akashskyash007/Fourth-Order-Gm-C-Chebyshev-Filter/Report.odt

PROJECT REPORT

Course Name: Active Filters

Course Code: EC447

Compiled By

Akash A (191EC102)

Kunapareddi Bhargav Rao (191EC222)

Submitted to

Professor Laxminidhi T

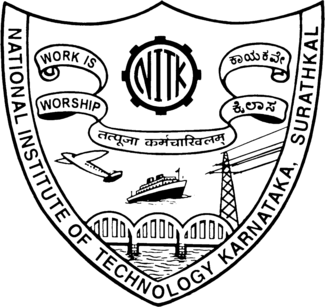
[picture p1: figure]

Problem Statement:

Design a Transconductance-C (Gm-C) low pass filter in 0.35 µm CMOS Technoogy node from TSMC using LTSpice Circuit Simulator (or any other suitable circuit simulator) for the given specifications.

Broad Expectations:

1. Realizing ideal Gm-C filter

a) Ideal filter using RLC circuits which meets the given specifications

b) Ideal Gm-C filter for the specifications using the macromodel for Gm

2. Designing the transconductor in 0.35 μm CMOS technology node from TSMC and validating its use as a Gm-C integrator. The capacitor calculated to be used in the first node of the filter may be used as the integrating capacitor for testing the Gm-C integrator.

3. Realize the transistor level Gm-C filter for the given specification.

General Specifications:

1. Fourth order Maximally flat response

2. Power supply 3.3 V

3. Use length of 0.5 μm for all transistors

4. Use even number of fingers for the transistors.

Transconductor Specifications:

1. Gm = 1 mS

2. Gate overdrive for input transistors = 200 mV

3. Input/output common-mode voltage = 1.65 V

Filter Specifications:

1. Attenuation at pass band edge = 0.5 dB

2. Band-edge= 70 Mhz

Theory: A maximally flat filter as the name suggests offers a flat magnitude response in the passband as compared to any other filter realized using the same order. The general expression for the magnitude response of an all pole low pass filter is given by:

{abs{ T_n(j %omega) }}^2 ~ = ~ { 1 } over { 1 + {abs{K_n (j %omega)}}^2 }

where,

{ abs{K_n (j %omega)} }^2 ~ = ~ B_{ 1 } %omega ^2 ~ + ~ B_{ 2 } %omega ^4 ~ + ~ ... ~ + ~ B_n %omega ^ { 2n }

for a prototype filter. n here represents the order of the filter. Mathematically, flatness of a function at a point is defined as the first and higher order derivatives of the function being equal to zero at that point. The greater the number of derivatives equal to zero, the more is the flatness of the function. We wish to make the polynomial Kn²(ɷ) maximally flat at ɷ=0 which would give maximal flatness for |Tn(jɷ )|² also at ɷ=0. Since all the derivatives if equated to zero gives a zero polynomial, we make the first (n-1) derivatives of Kn²(ɷ) with respect to ɷ² equal to zero. This gives us the result:

{ abs{K_n(j %omega)} }^2 ~ = ~ B_n %omega ^{ 2n }

The magnitude response curve of a general low pass filter is shown below:

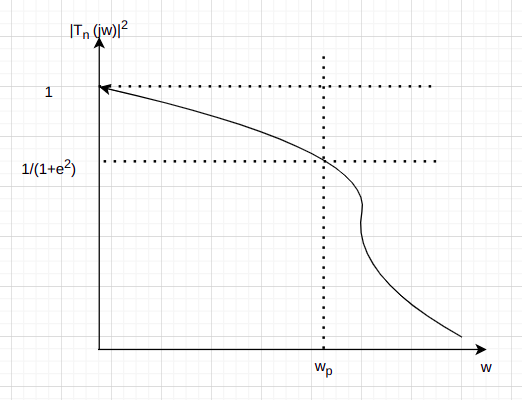
[picture p2: figure]

Thus, it can be observed that at the passband edge (ɷp = 1 rad/sec),

{ abs {T_n (j %omega)} }^2 ~ = ~ { 1 } over { 1 + %epsilon ^2 }

from which it can be shown that Kn²(ɷ) = ϵ². This in turn implies that Bn = ϵ²..

drarrow { abs {K_n (j %omega)} } ^2 ~ = ~ %epsilon ^2 %omega ^ { 2n }

drarrow { abs {T_n (j %omega)} }^2 ~ = ~ { 1 } over { 1 ~ + ~ %epsilon ^2 %omega ^ {2n} }

The special case of ϵ = 1 is known as a Butterworth filter. Attenuation can be written as the inverse of gain and in dB scale we can write the attenuation as shown below:

%alpha _{ dB } ~ = ~ 10 log(1 ~ + ~ %epsilon ^ 2 %omega ^ {2n})

From the above formulas, it is implicitt that a Butterworth filter offers a gain of -3 dB at its passband edge. A maximally flat filter can be viewed as a Butterworth filter at some other passband frequency. The expression for this passband edge can be found by equating the magnitude responses of a maximally flat and Butterworth filter and is given below:

%omega _{ p, B } ~ = %omega _ { p, MF } %epsilon ^ { -1 over n }

Thus, once we find the values of ϵ and n, we transform the maximally flat filter to a Butterworth filter and then design the Butterworth filter. This is done since the design procedure for a Butterworth filter is standardized and tables are available with numerical values that can be used to quickly design the filter.

Once we have the magnitude response, we must find the pole locations of the filter. This can be done using the relation:

{ abs {T_n (j %omega) } }^2 ~ = ~ T_n( j %omega )T_n( -j %omega ) ~ = ~ T_n( s )T_n( -s ) at s ~= ~j %omega

drarrow T_n( s )T_n( -s ) ~ = ~ { abs{T_n(j %omega)} }^2 at %omega ~= ~s over j

Thus, for a fourth order Butterworth filter that we are required to design,

T_4( s )T_4( -s ) ~ = ~ 1 over { 1 + s^8 }

The pole locations of the above transfer function are given by:

s ~ = ~ e^{ j(2k+1)%pi over 8 } ~~~~~~~~~~ for k = 0, 1, 2, ..., 7

The poles of the fourth order Butterworth filter thus lie on a unit circle and have been plotted as shown below:

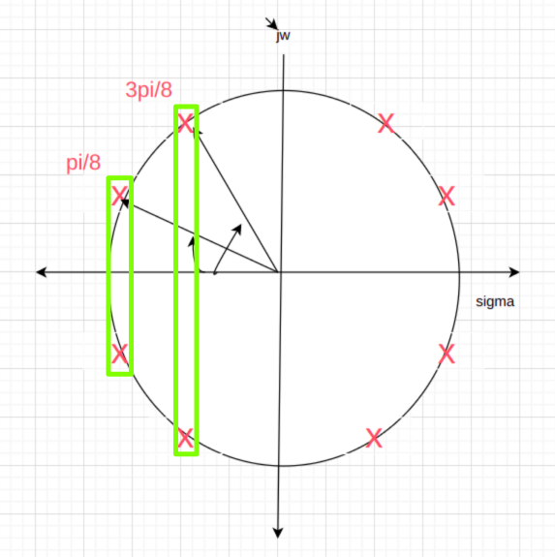
[picture p3: figure]

To ensire stability, we take the oles on the left half of the s plane to be the poles of T4(s). As shown in the above figure, the fourth order Butterworth filter can be realized using two second order sections each with passband edge of 1 rad/sec. The quality factor of a second order circuit from its pole locations on the unit circle are given by:

Q ~ = ~ 1 over { 2 cos %psi }

where ѱ is the angle made with the negative real axis by the two complex conjugate poles. From the above relation, the quality factors of the two second order filters can be shown to be Q1 = 0.541 and Q2 = 1.307. The transfer function of the fourth order filter is thus given by:

T_4( s ) ~ = ~ 1 over { (s^2 + 1.848s + 1)(s^2+0.765s+1) }

A second low pass filter can be realized using a series RLC circuit where output is taken across the capacitor. For a prototype filter, we normally choose R = 1 Ω, L = Q H and C = 1/Q F. By cascading two low pass filters with a buffer realizing using opamp to avoid the loading effect, the fourth order Butterworth filter shown above can be realized. The RLC circuit for the same is as shown below:

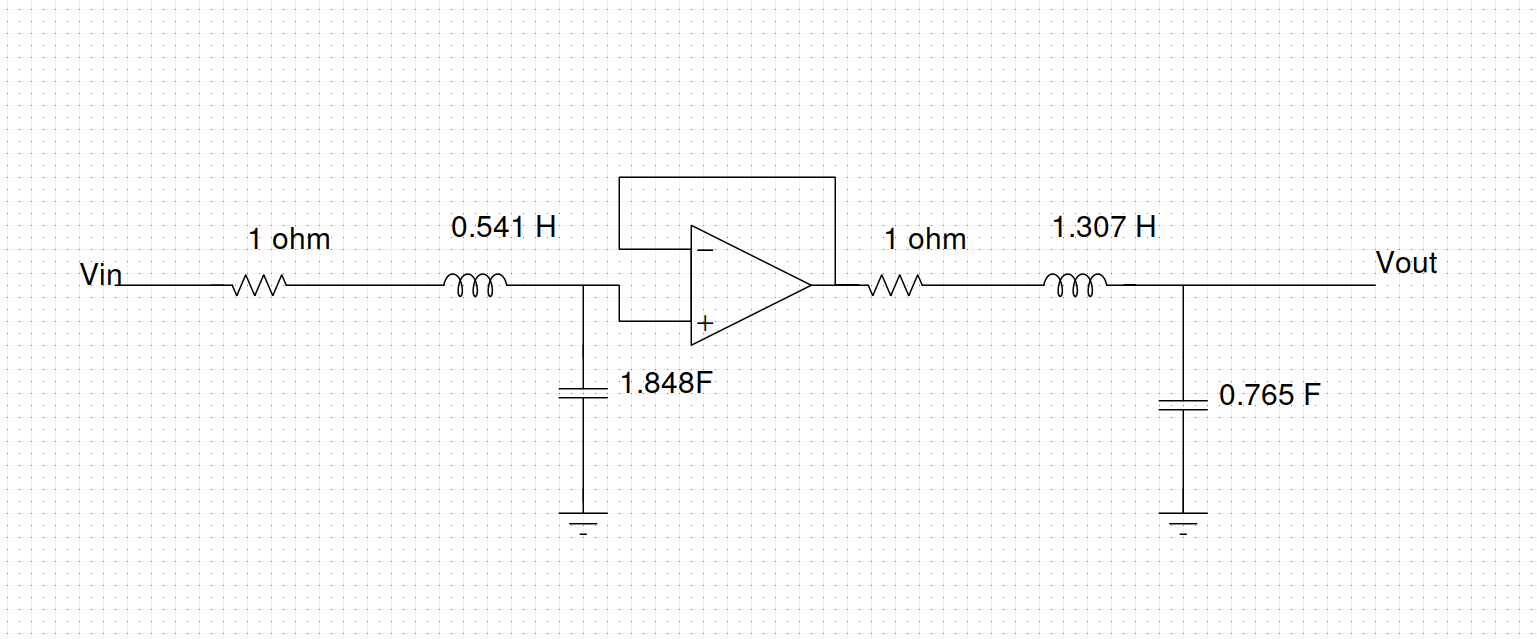
[picture p4: figure]

In order to arrive at the Gm – C equivalent, we normally start off with a band pass filter and realize the inductor and resistor using transconductors. This is done since converting the above circuit directly to its Gm – C equivalent produces a non-integrating node at the terminal between the resistor and the floating inductor and the parasitic capacitances cannot be absorbed. The bandpass equivalent has no non-integrating node and thus, the parasitic capacitances can be absorbed into the integrating caacitors. Thus, the order of the circuit remains the same and we also obtain a more exact version of the desired response. The output of the gyrator used to realize the inductor is then a low pass node. The Gm – C equivalent of the above circuit is shown below. We also note that the section with a lower quality factors have been placed and then followed by sections with high quality factors. This is done since higher quality factors have gains greater than one in their magnitude response and if placed early on in the cicuit, they will amplify the non-linear distortions to a higher extent.

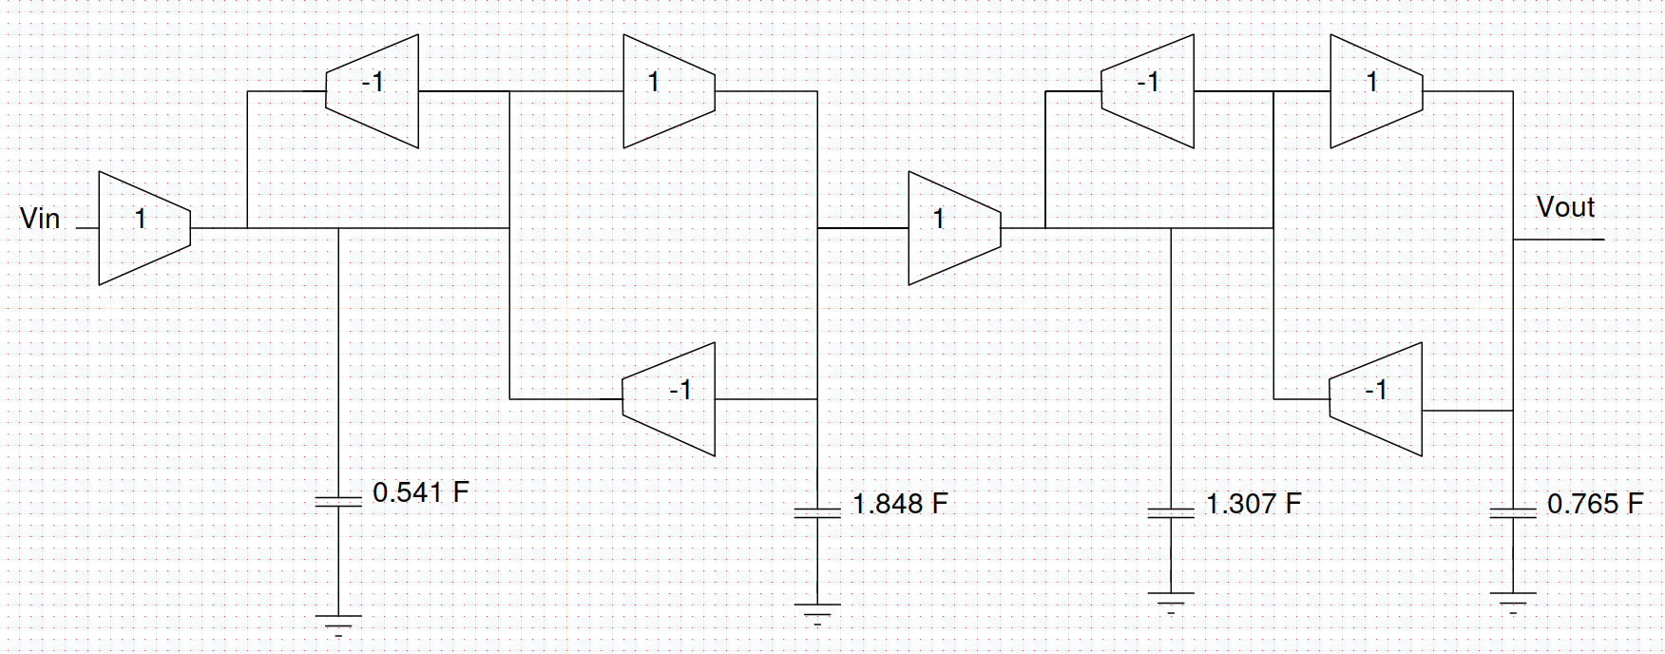
[picture p5: figure]

Design:

We are told that the attenuation at the passband edge must be -0.5 dB. Applying the formula for attenuation for a prototype (ɷp = 1 rad/sec),

0.5 ~ = ~ 10log( 1 + %epsilon ^2 ) ~ drarrow ~ %epsilon ~ = ~ 0.349

The passband edge for the maximally flat filter is given to be 70 Mhz. Since we are realizing a fourth order filter, n = 4. Thus, to convert the maximally flat filter to a Butterworth filter, we find the passband edge for the Butterworth filter using the formula told earlier.

%omega _{ p, BF } ~ = ~ ( 2 %pi * 70 ) * ( 0.349 )^( -1 over 4 ) ~ drarrow ~ %omega _{ p, BF } ~ = ~ 572.231 Mrad/sec ~= ~ 91.07 MHz

Thus, we need to design a fourth order Butterworth filter with a passband edge of 572.231 Mrad/sec. Earlier, we have designed a prototype Butterworth fourth order filter with a passband edge of 1 rad/sec. Thus, we just need to frequency scale the circuit. Further the impedance level of the prototype is 1Ω. Since the Gm value that we need to realize is 1mS, we also need to impedance scale the circuit to a resistance value of 1kΩ. The final RLC and Gm-C circuits after performing frequency and impedance scaling is as shown below:

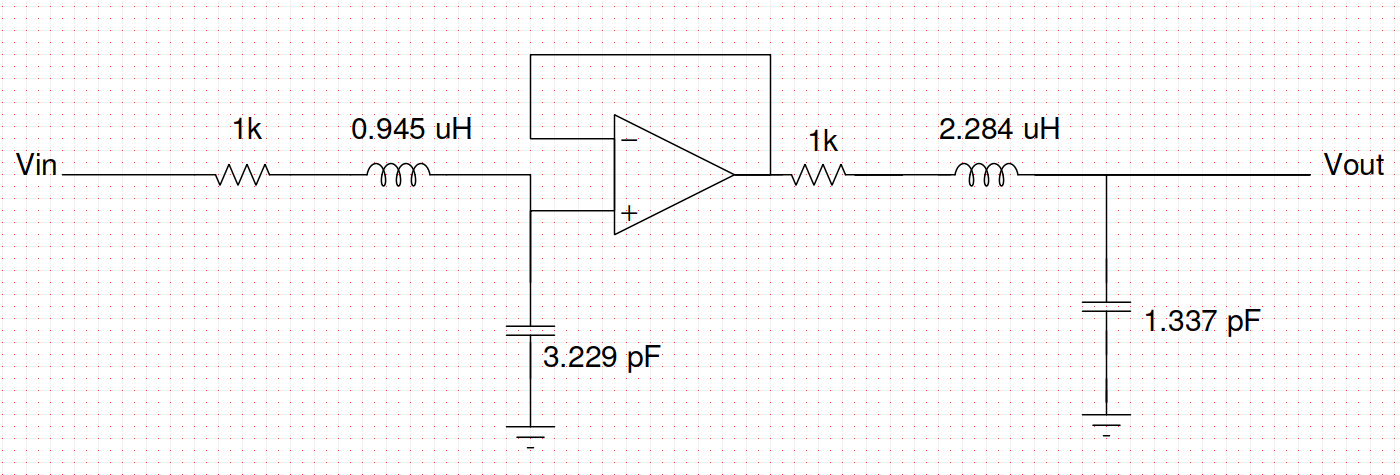
[picture p6: figure]
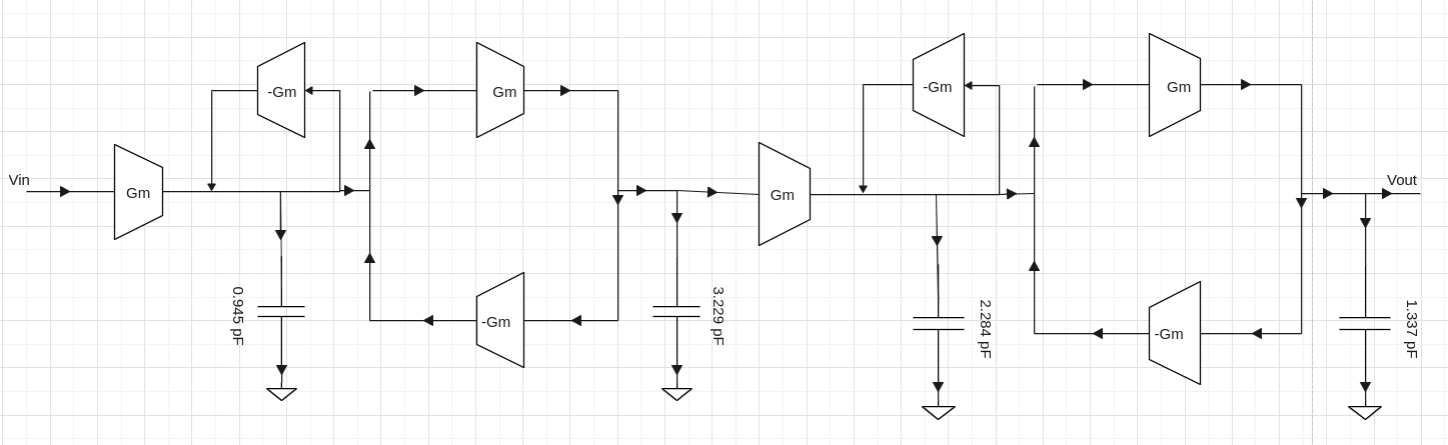
[picture p7: figure]

To design the transconductor, a common source differential pair was used with NMOS transistors as input transistors and PMOS transistors as the load transistors. Common mode feedback was implemented to ensure that the output common mode voltage is same as the input common mode voltage. This is essential for proper operation of the circuit since the output of one transconductor is given as input to the next transconductor. The basic configuration of the transconductors is as shown below:

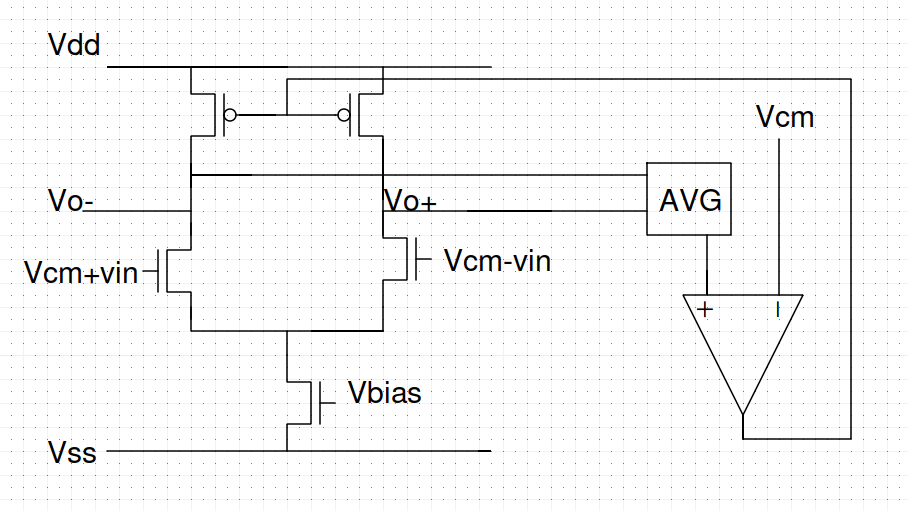
[picture p8: figure]

We need to set the width of the transistors and the drain current so that the correct transconductance (gm) is achieved. Simultaneously, specification is also given for the gate overdrive voltage Vdsat. The following expressions are used to achieve the required gm and Vdsat:

gm ~ = ~ sqrt { 2KI_D }

I_D ~ = ~ K over 2 ( Vdsat )^2

K ~= ~ %mu _n C_{ ox }( W over L )

Initially, we begin by setting arbitrary widths for the NMOS transistors and observing the values of Vdsat. If Vdsat is say less than required, we can either increase the drain current (by increasing the bias voltage to the tail NMOS) or by reducing the width of the transistors. Once, we achieve the required Vdsat, we now need to achieve the desired gm without changing the value of Vdsat. From the above expressions, to increase the gm without changing Idsat, both K and the drain current must be increased by the same factor. The reverse holds true for decreasing gm. Once we achieve the required gm and Vdsat, the transconductor is ready for use in the final circuit. We can then replace the Gm’s by the transistor level implementation and make the circuit fully differential.

SIMULATIONS AND OBSERVATIONS

1. RLC and Gm-C Macromodel Realization:

Circuit Schematic

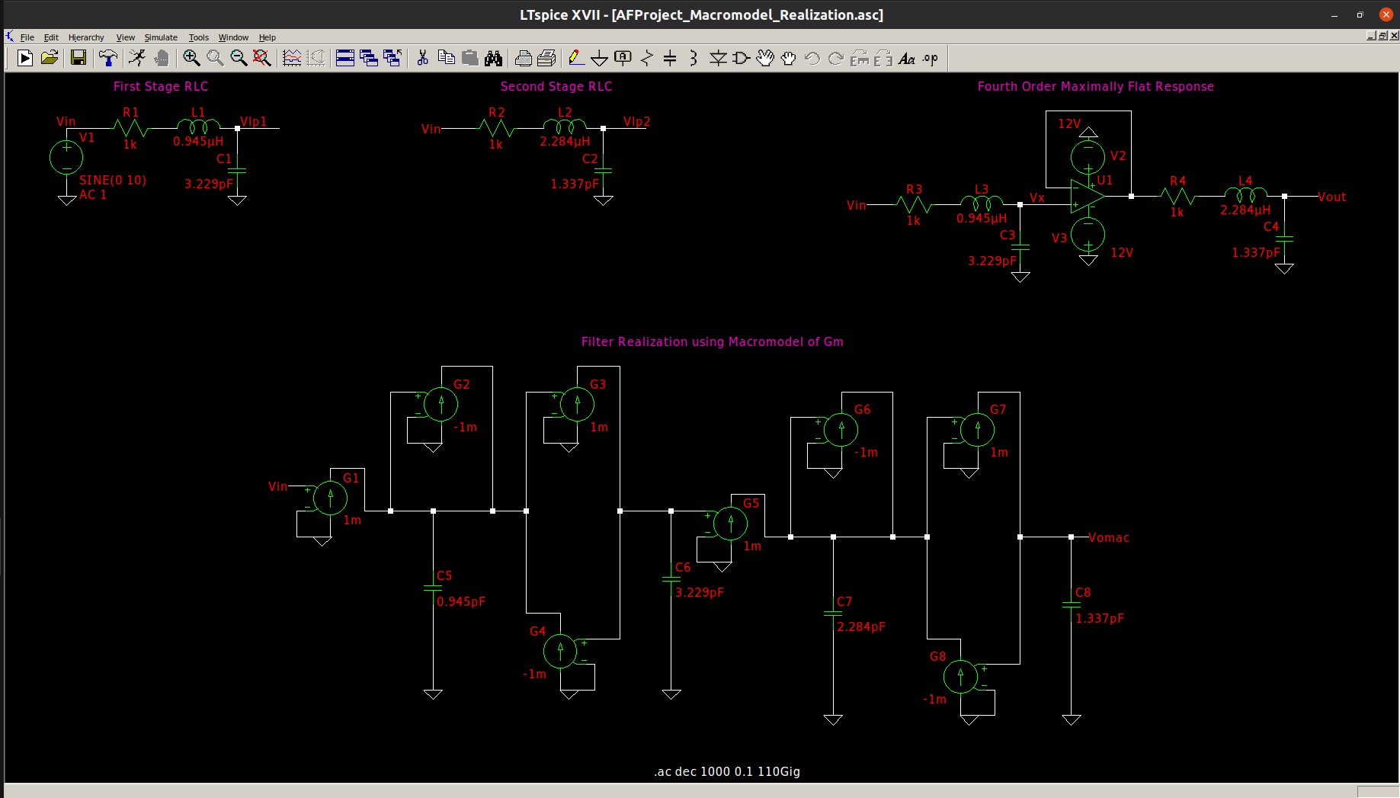
[picture p9: figure]

RLC First Stage Waveform

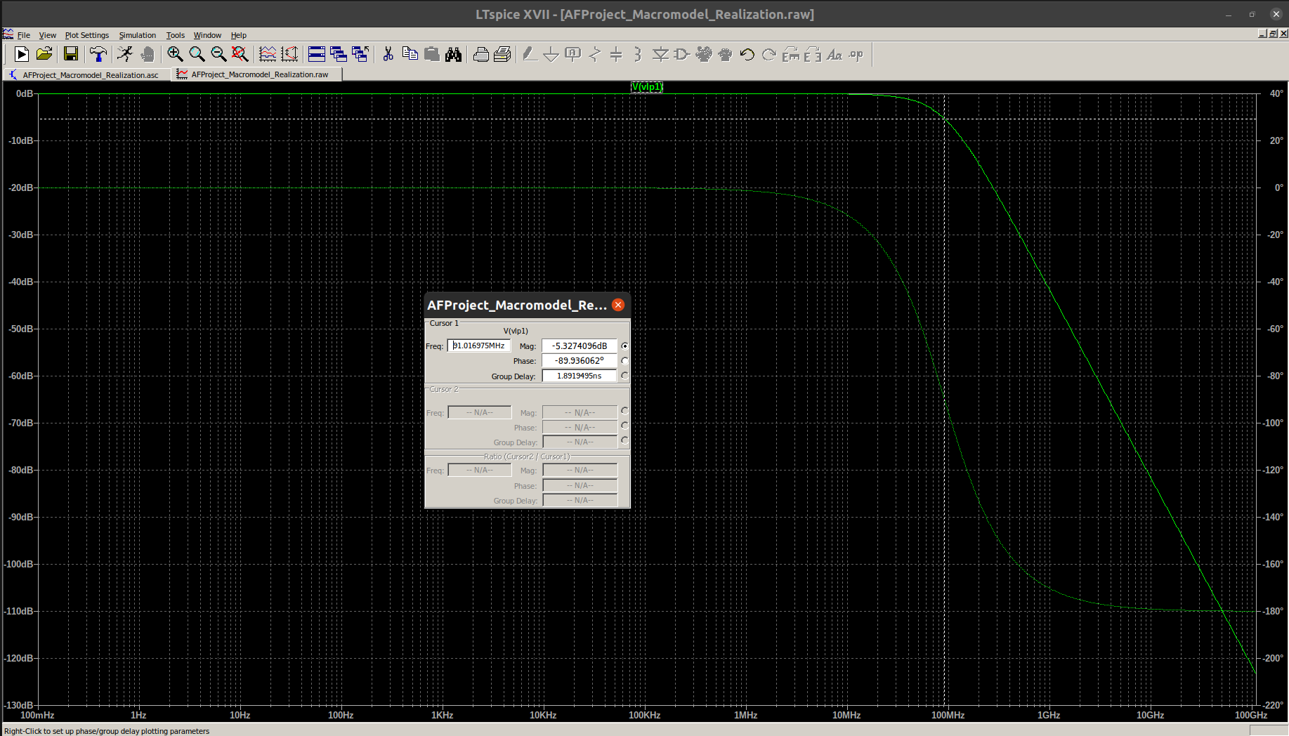
[picture p10: figure]

RLC First Stage Rolloff

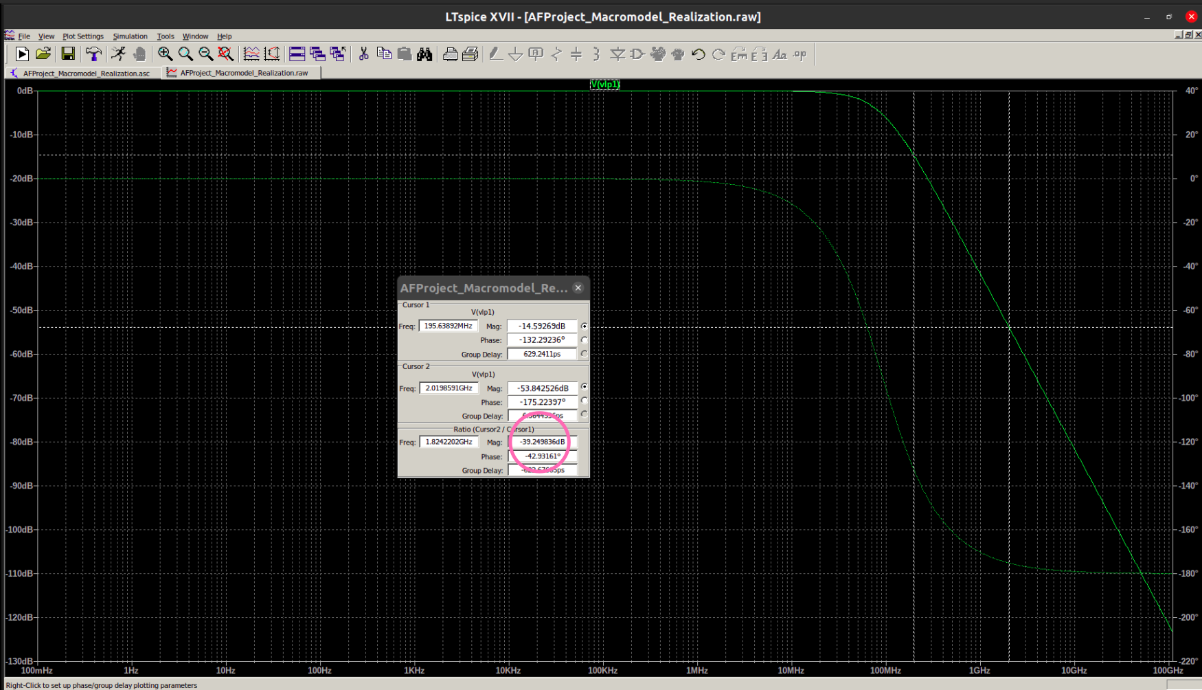
[picture p11: figure]

Second Stage RLC Waveform

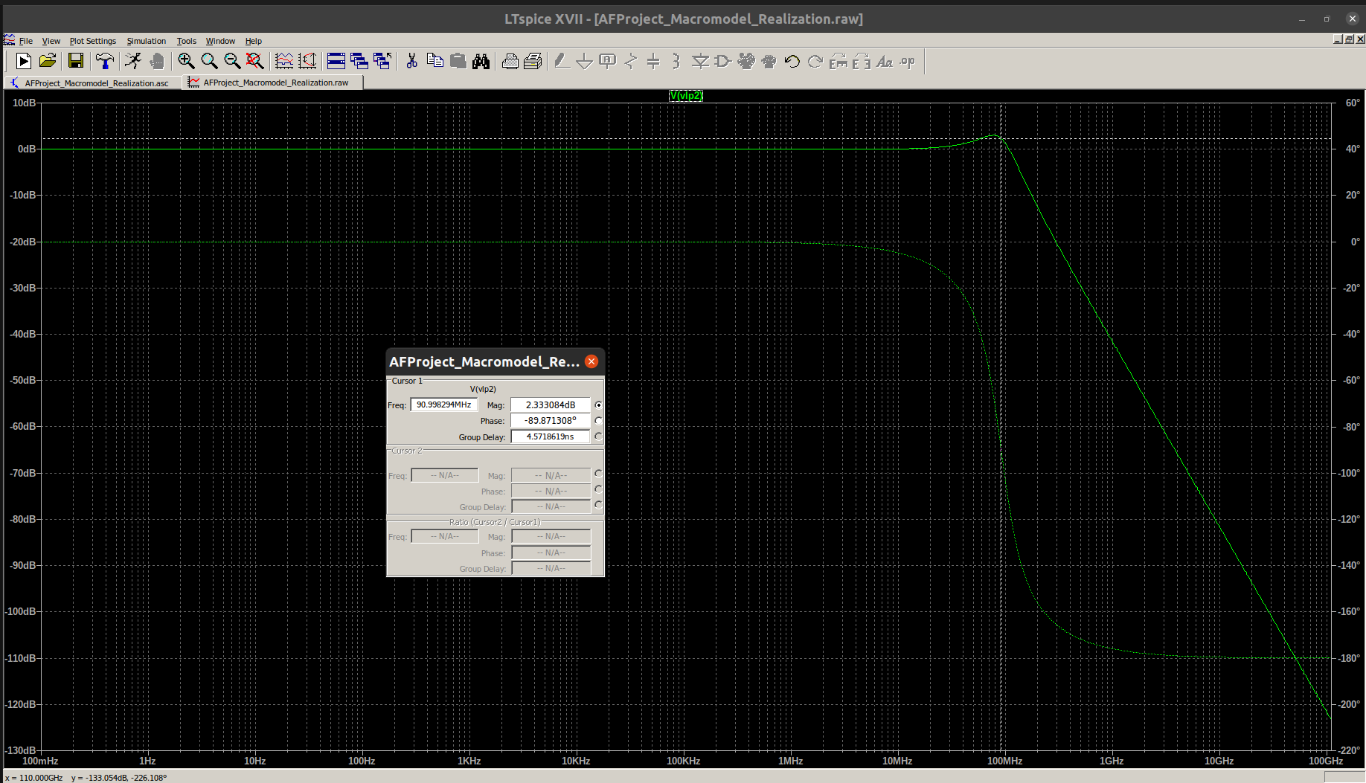
[picture p12: figure]

Second Stage RLC Rolloff

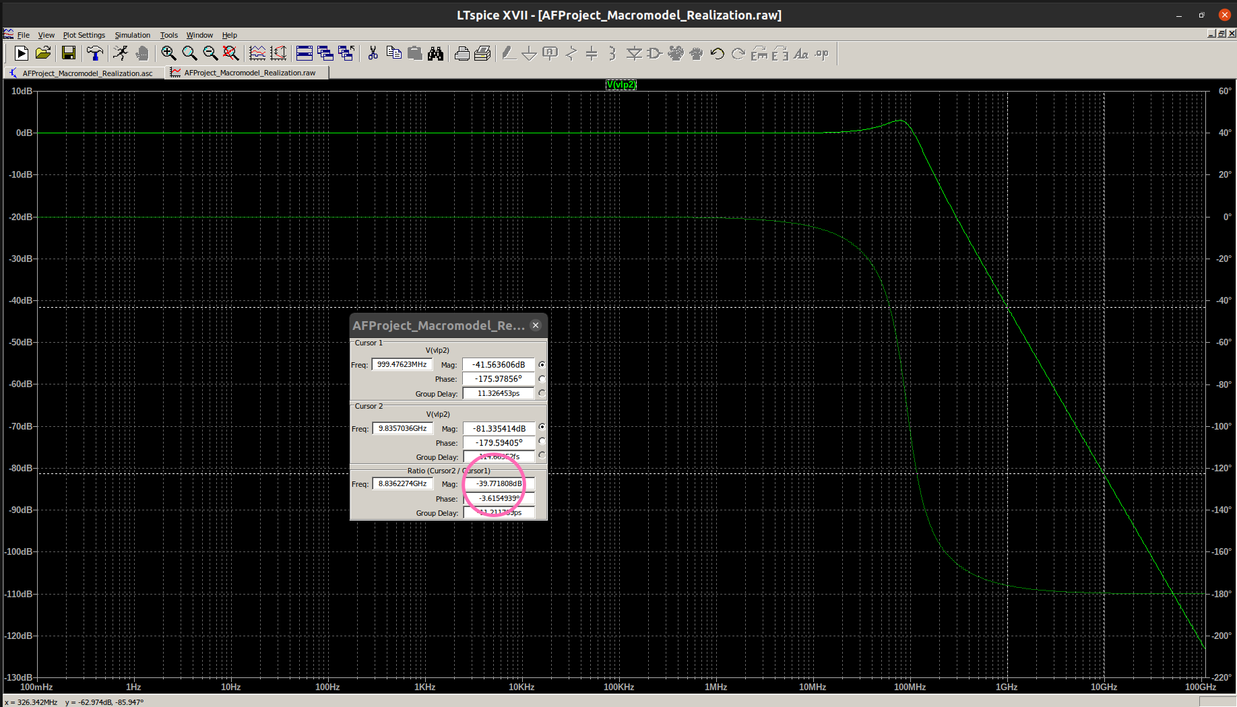
[picture p13: figure]

Complete RLC Realization Waveform

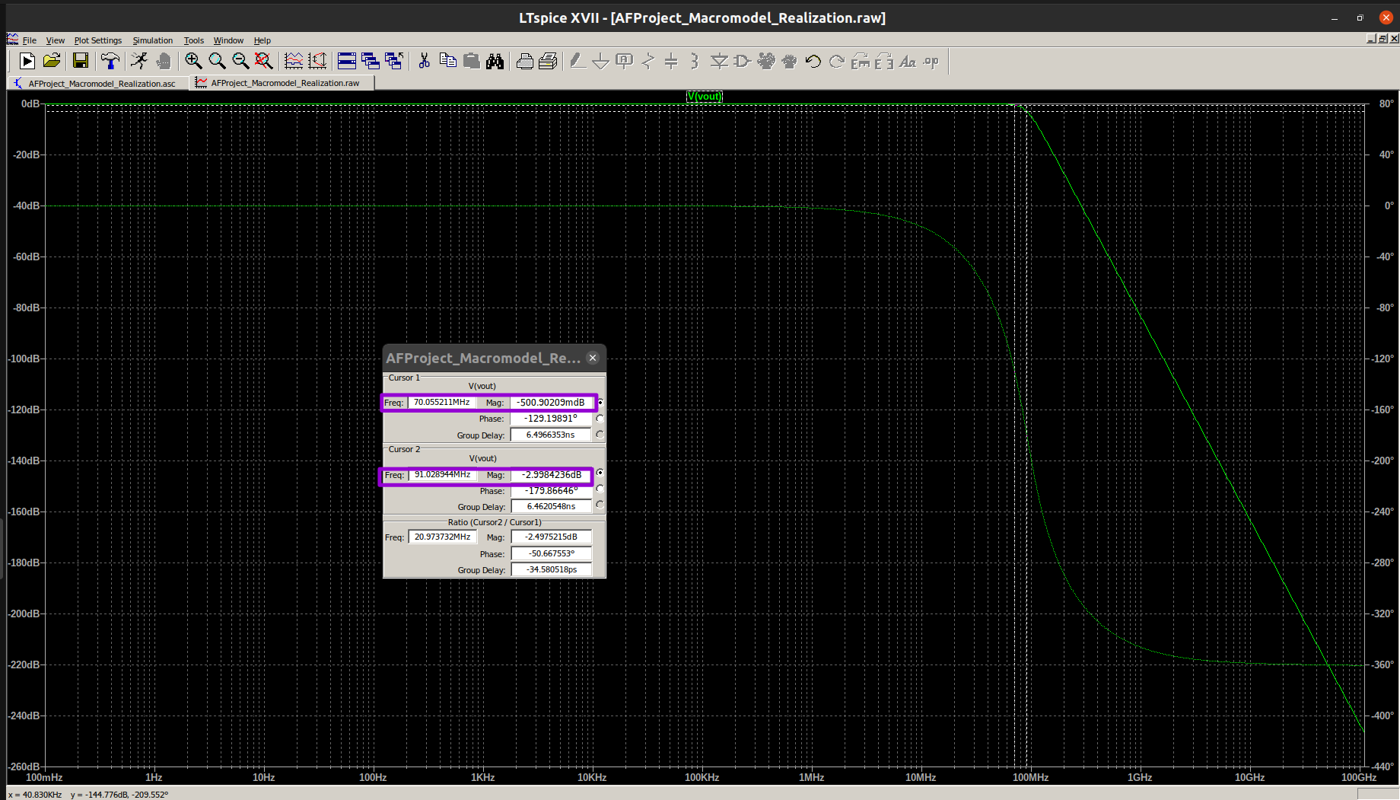
[picture p14: figure]

Complete RLC Realization Rolloff

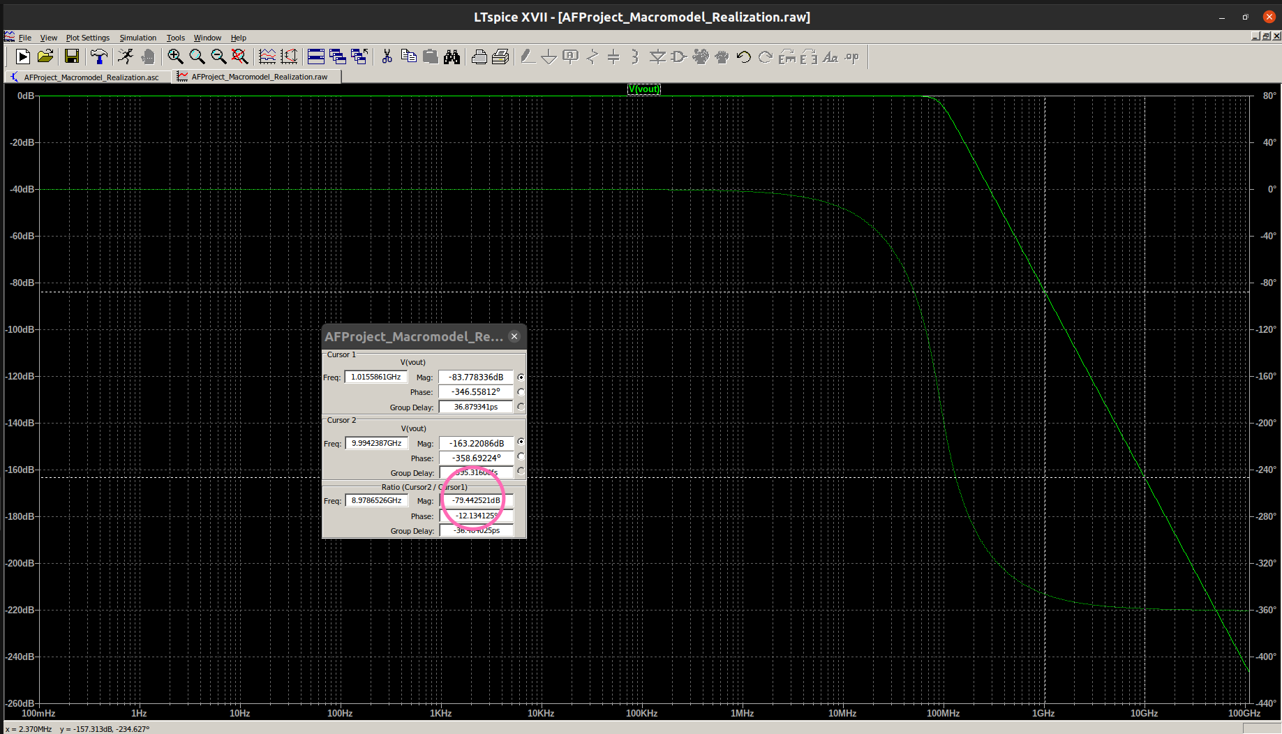
[picture p15: figure]

Gm – C Realization Waveform:

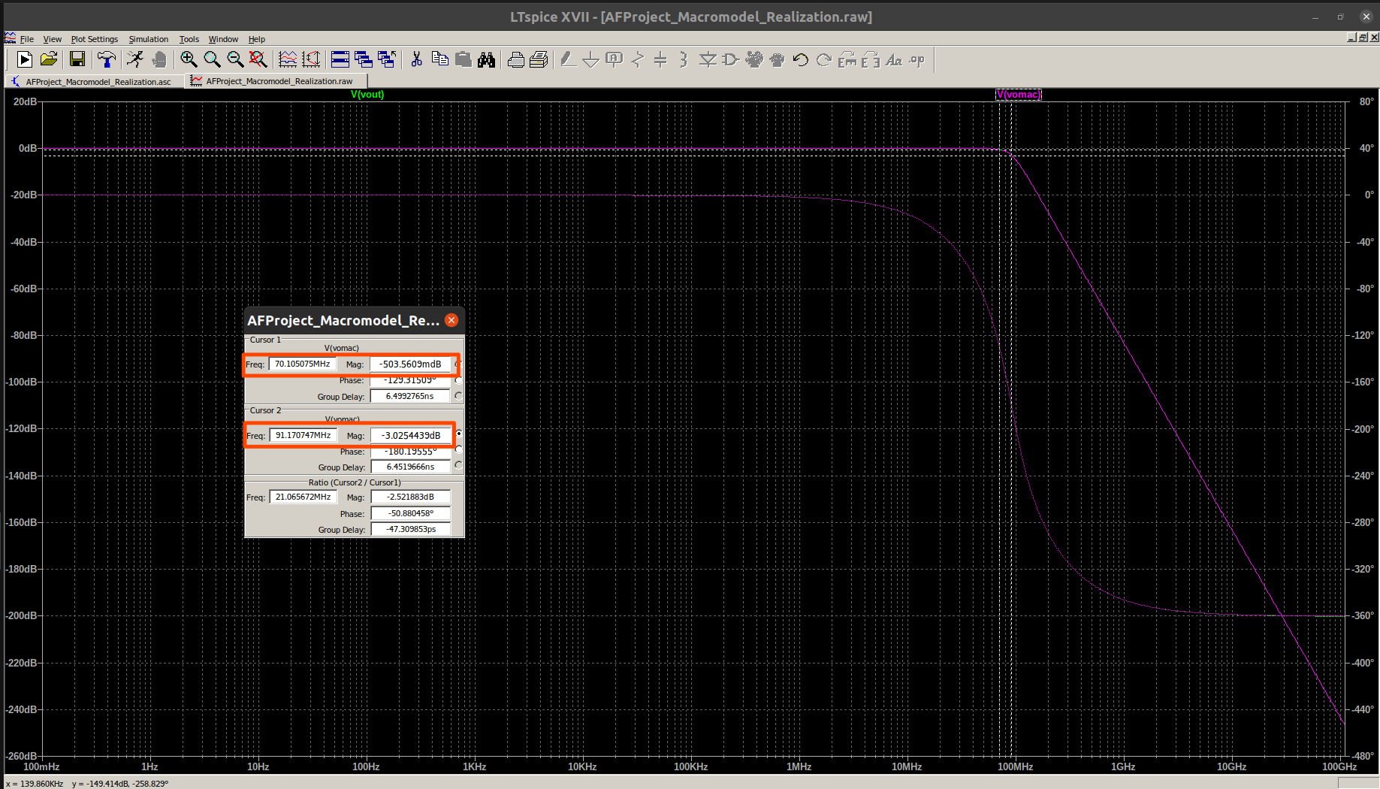
[picture p16: figure]

Observations:

- The first and second stage RLC circuits offer a DC gain of 0 dB. At the Butterworth passband edge of approximately 91 Mhz, each offers a gain equal to the quality factor in decibel. The rolloff for each of the second order filters is observed to be -40 dB/decade.
- The final fourth order RLC realization offers a gain of approximately -500 millidecibels at the passband edge of 70 Mhz and a gain of -3 dB at the Butterworth passband edge of 91 Mhz. The rolloff of the fourth order filter is observed to be -80 dB/decade. The phase plot varies from 0 degress to -360 degrees.
- The Gm – C realization exactly coincides with the RLC realization and offers the same gain and rolloff.
- Thus, the circuit realized using ideal transconductors provides the desired response which verifies the fact that our design is correct.

Now that we have realized the RLC and Gm – C macromodel circuits, the next step is to convert our singled ended circuit to a fullydifferential circuit which takes in positive and negative voltages and gives out both positive and negative voltages. This is done since differential circuits are known to offer better linearity as compared to single ended circuits. In the next step, we build a fully differential circuit using Gm macromodels. A fully differential macromodel was created in LtSpice using two voltage controlled current sources.

2. Fully Differential Macromodel Realization

Circuit Schematic

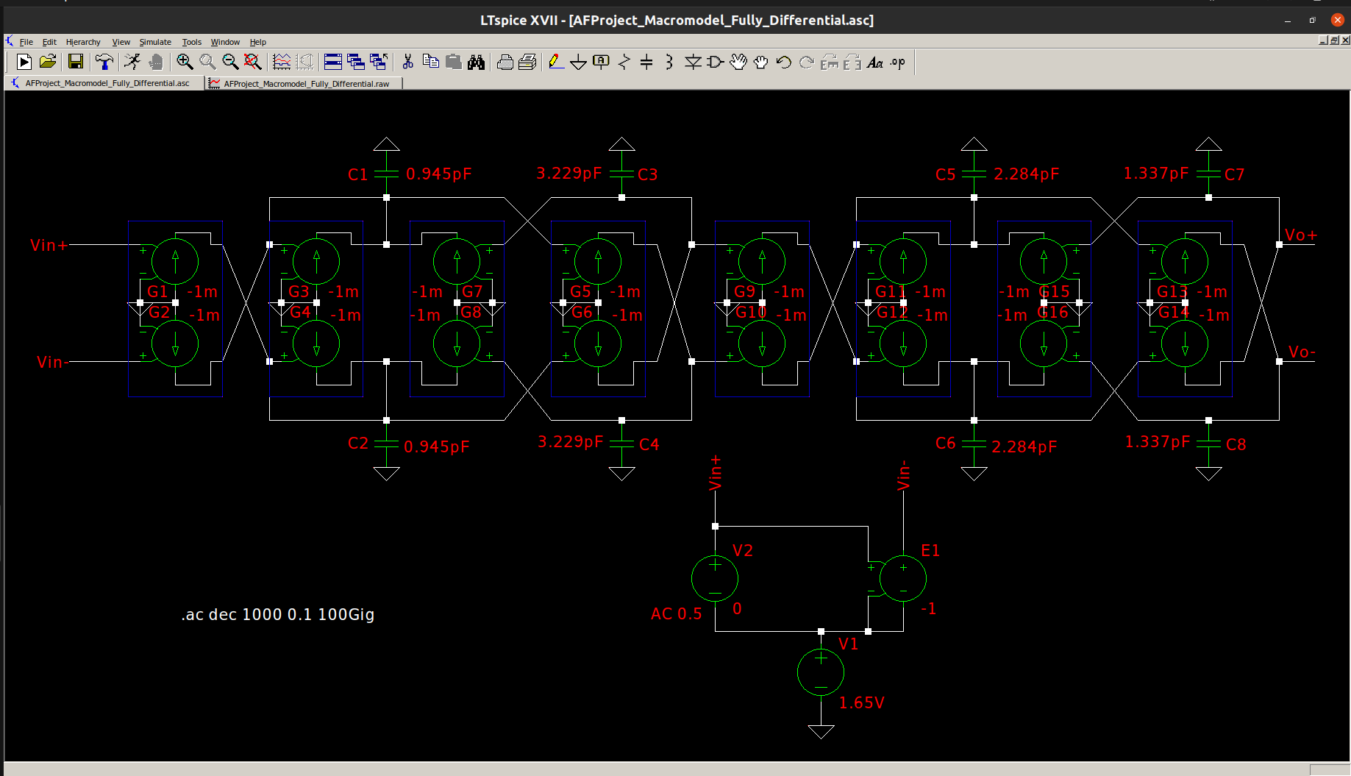
[picture p17: figure]

Waveform:

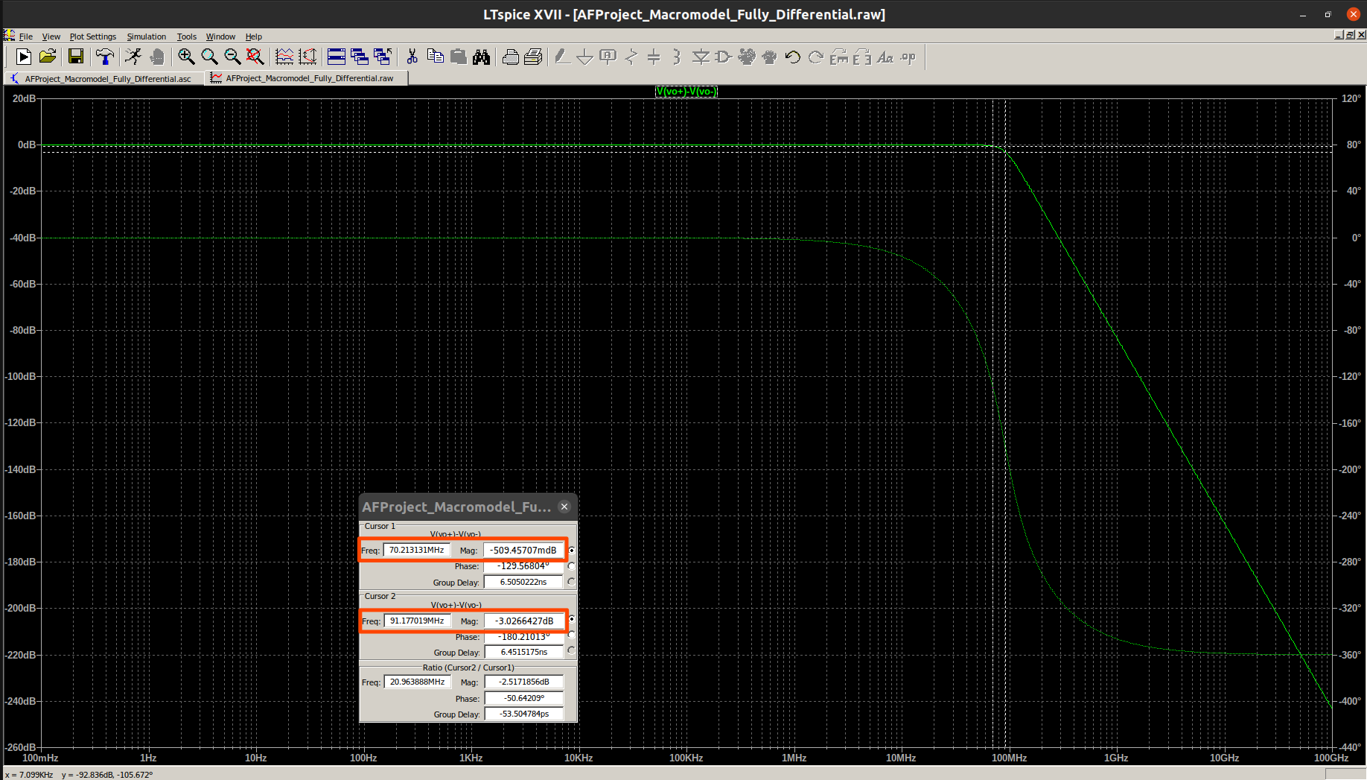
[picture p18: figure]

Rolloff:

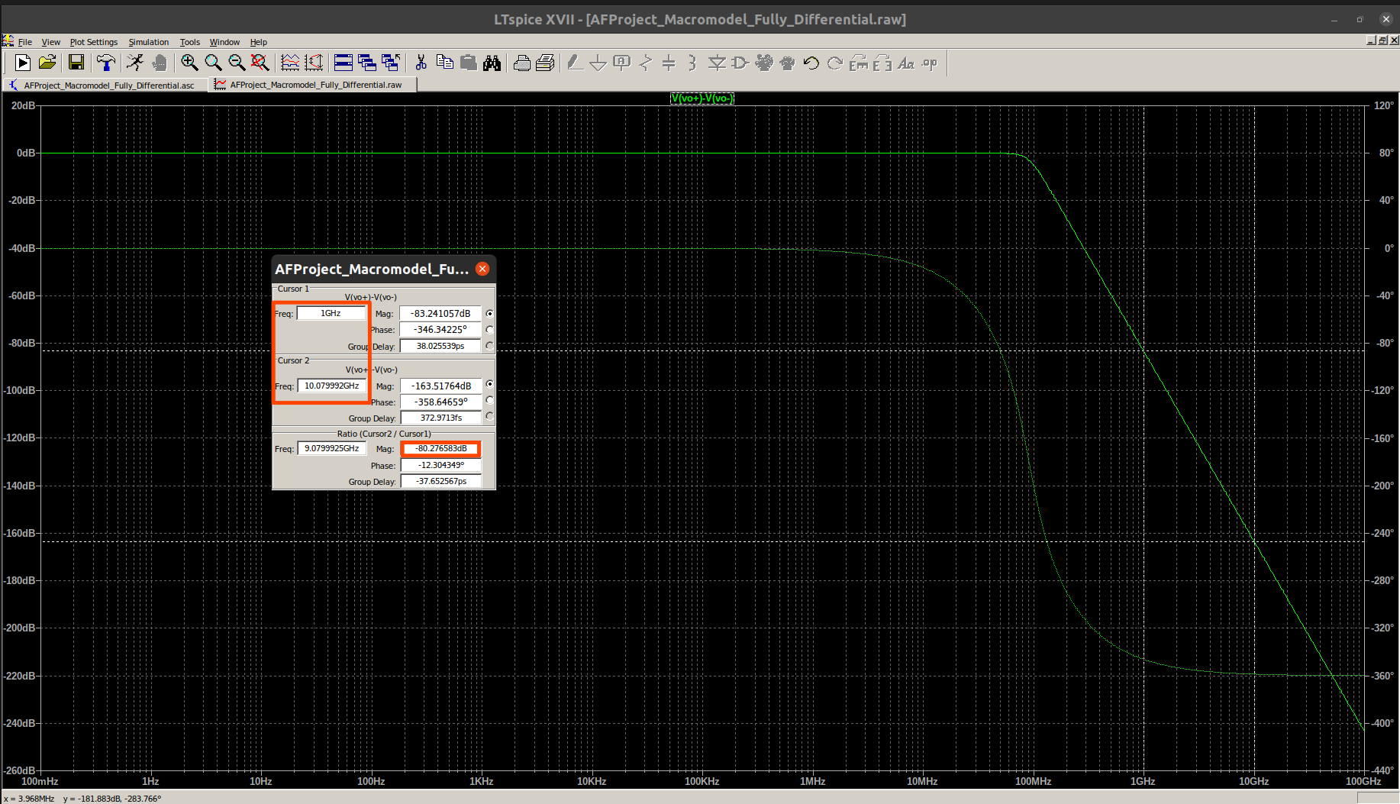
[picture p19: figure]

Thus, the fully differential circuit offers the exact same response as the single ended circuit which verifies its correctness

3. Transconductor Design:

Circuit Schematic

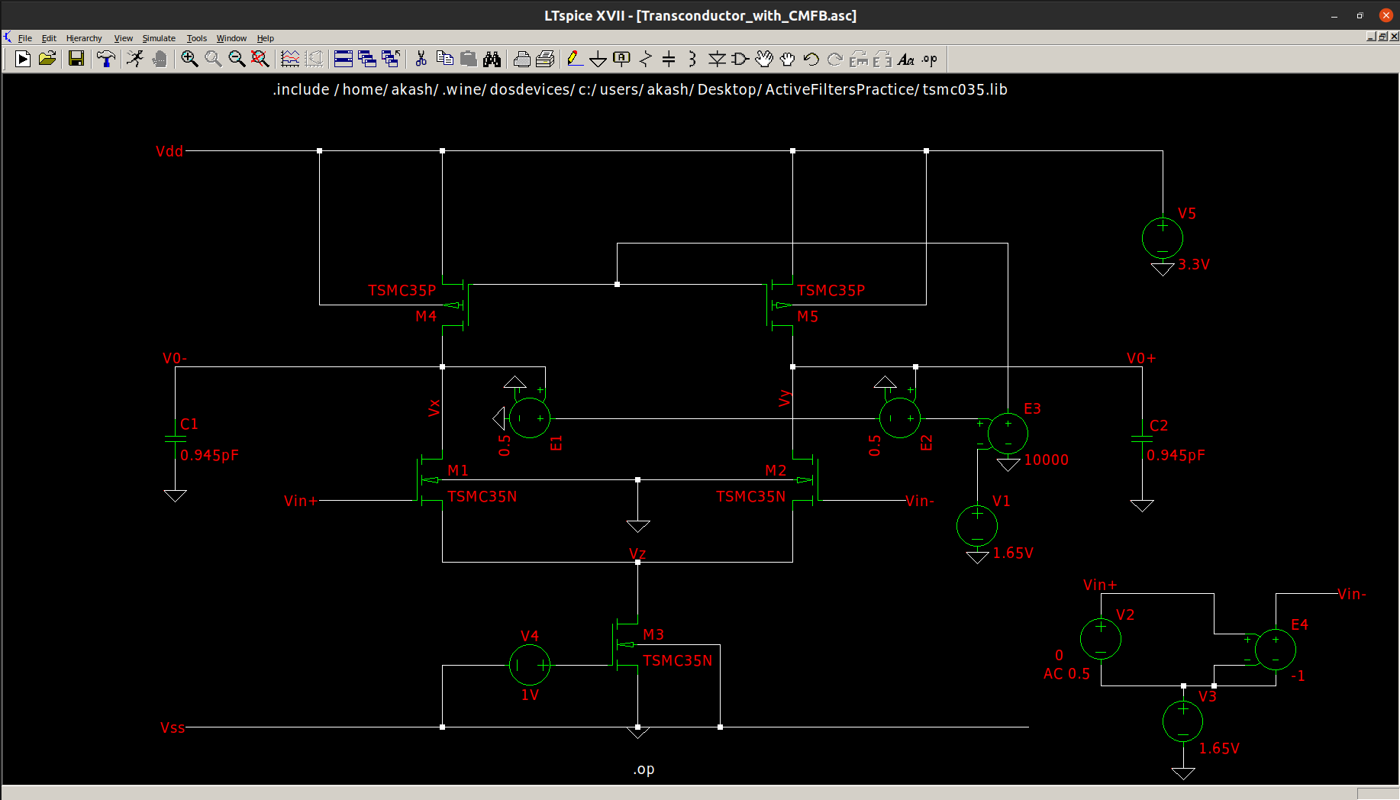
[picture p20: figure]

DC Operating Point

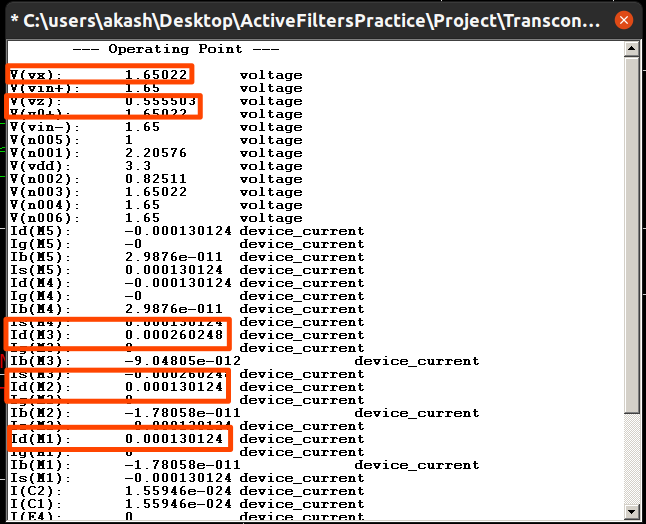
[picture p21: figure]

Spice Log:

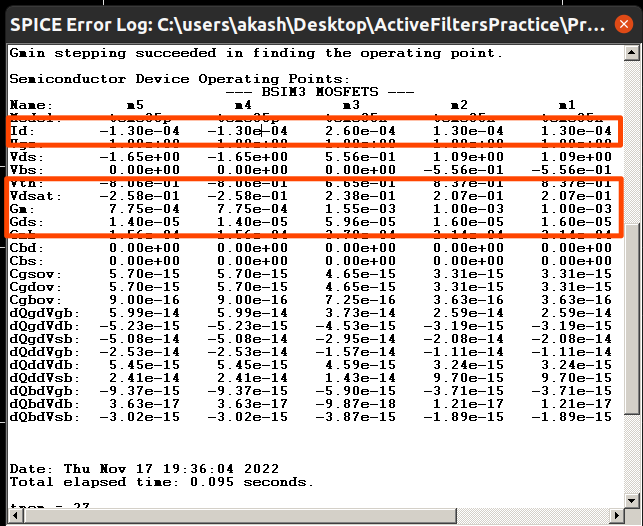
[picture p22: figure]

Output Voltage Waveform of Gm – C integrator

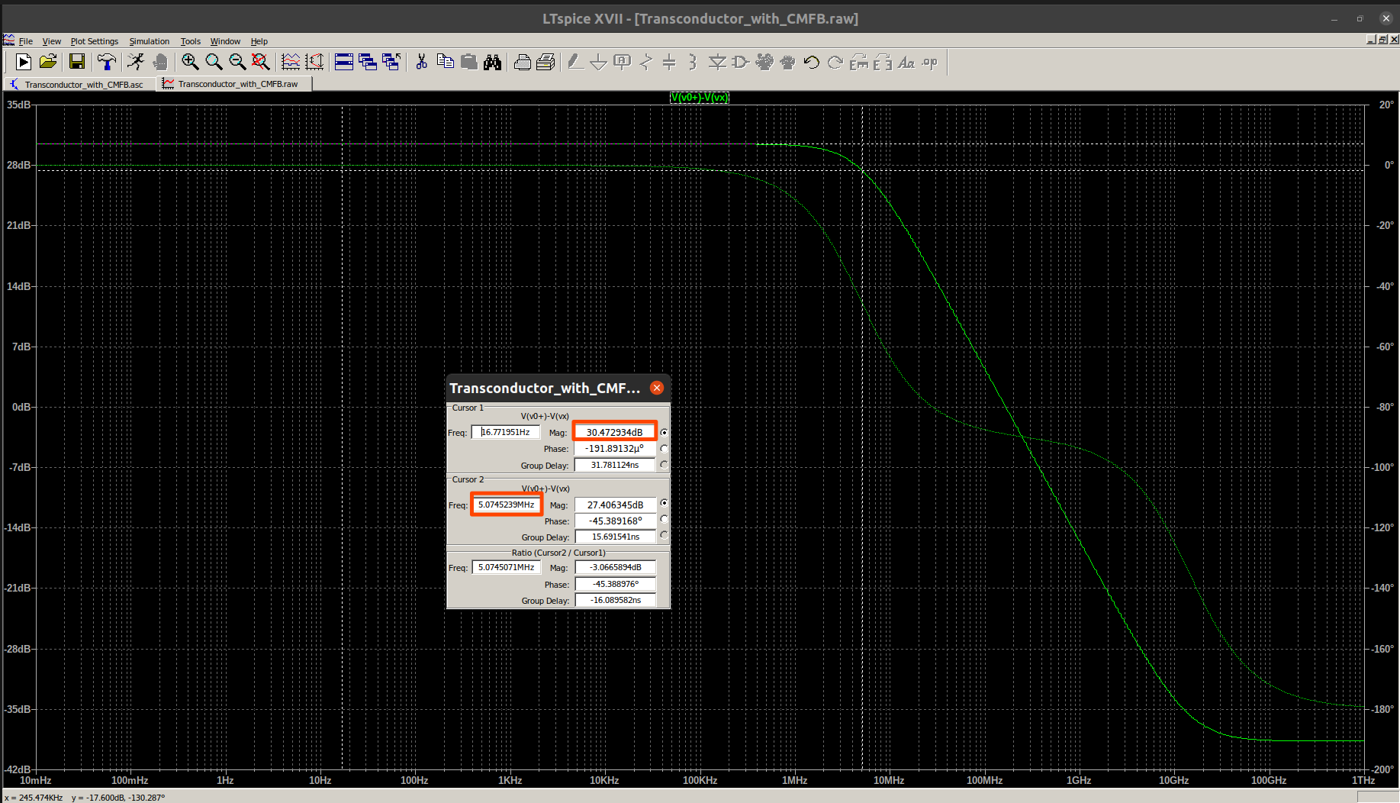
[picture p23: figure]

Output Current Waveform of Gm – C integrator

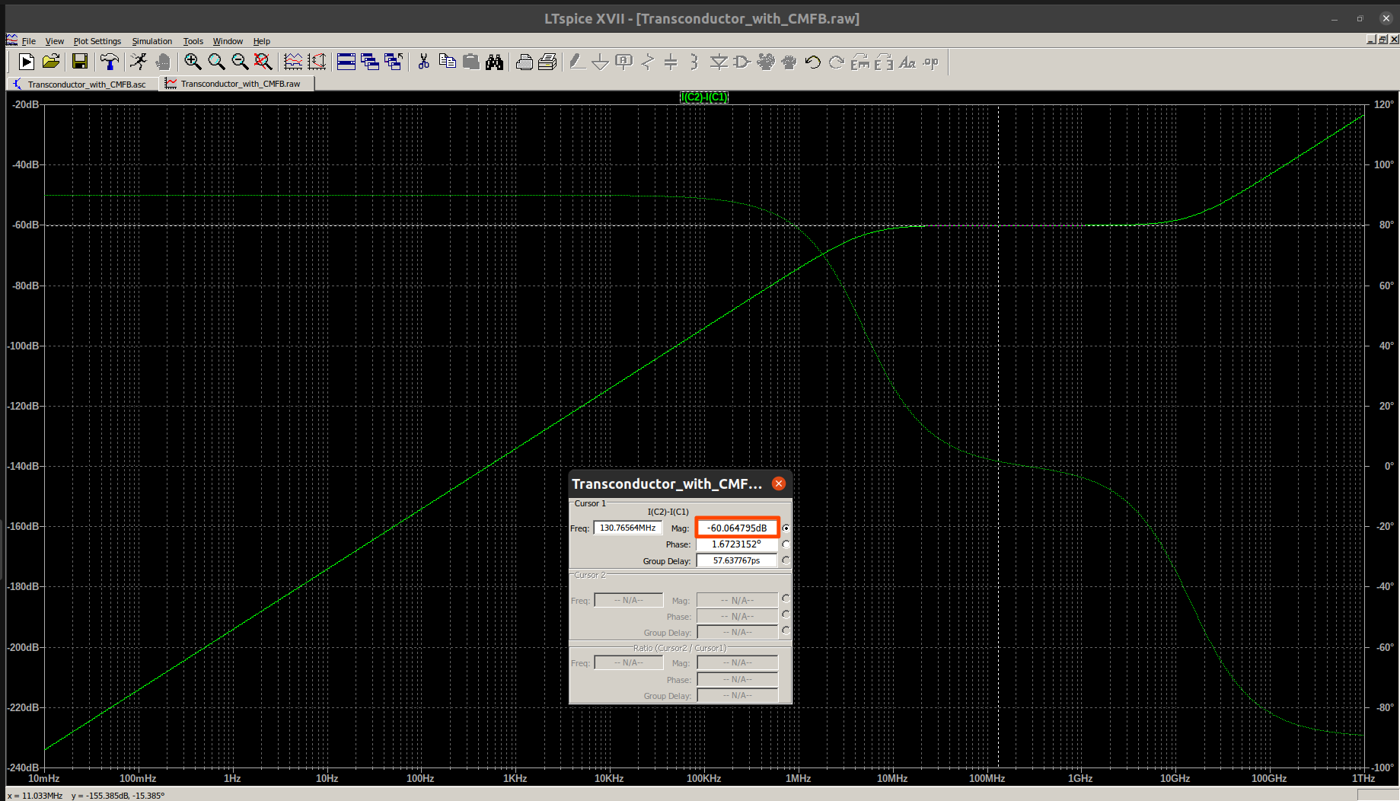
[picture p24: figure]

Observations:

- From the operating point characteristics, we observe that the input operatingvoltage has been set to 1.65 V (common mode input) and the output operating voltage is 1.65022 V. We wanted the exact operating voltage at output to be 1.65 V so that input could be given to the next transconductor. The error arises from the fact that in the common mode feedback, we have used an error amplifier with a gain of 10,000 whereas the theoretical gain should be infinite. Thus, we have gotten the steady state error in the fourth decimal place. However, this error is negligible and it was observed that it did not affect the circuit operation greatly.
- From the Spice Error Log, the values of Gm for transistors M1 and M2 is observed to be 1mS as expected. This is also by definition the transconductance of the overall circuit. Further, it can be observed that the Vdsat (gate overdrive) of the transistor M1 and M2 is 207 mV. For the specifications, we need to get 200 mV. Thus, we have almost exactly realized the specifications on the transconductor. We also need to note the values of Gds for the NMOS and PMOS transistors. These are contributed by channel length modulation effect and cause non-idealities in the Gm – C integrator by appearing as a parasitic grounded resistor. Since both these resistors from M1 and M4 (or M2 and M5) appear in parallel, we can add the Gds values to get the overall non-ideal resistance at the output nodes. The channel length modulation effect of M3 can be ignored since node Vz acts as a small signal ground and thus, no current can flow through this resistor as boh the terminals have been grounded. The total non-ideal admittance at each of the output nodes is calculated as follows:

G_{ n i } ~ = ~ 1.6*10^{ -5 } ~ + ~ 1.4*10^{ -5 } ~ = ~ 3*10^{ -5 }S ~drarrow~ R_{ n i } ~ = ~ 1 over G_{ n i } ~= ~ 33.33 k %OMEGA

- The output of the Gm – C integrator is ideally expected to be a straight line with slope of ~~20~~ dB/decade where it across the 0dB line at ɷ = Gm/C. However, our actual output appears to have a low pass response with some dc gain. This can be shown to be correct if the nonideal resistor is taken into account. The circuit of anon-ideal Gm – C integrator that we have realized is as shown below:

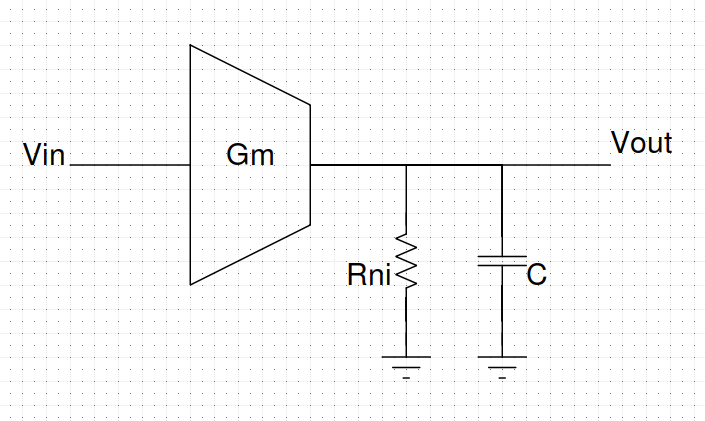
[picture p25: figure]

The RLC equivalent of the above circuit is as shown below:

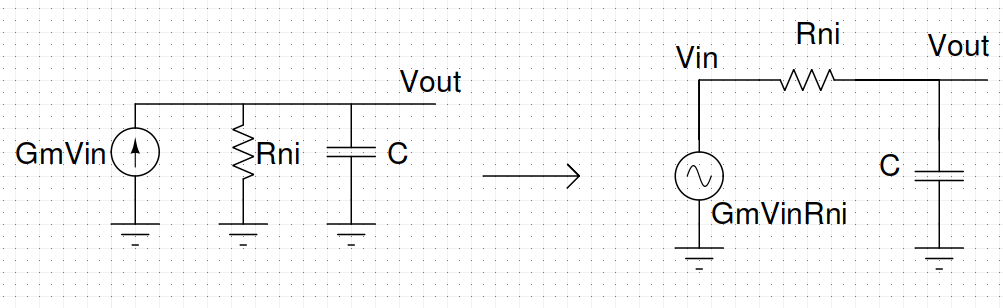
[picture p26: figure]

Thus, the non-ideal Gm-C integrator is nothing but a first order low pass filter. The cutoff frequency of this low pass filter is given by:

%omega _{ o } ~ = ~ 1 over { R_{n i } * C} ~ = ~ 1 over { 33.33 * 10^3 * 0.945 * 10^-12 } ~ drarrow ~ %omega _{ o } = 31.749 Mrad/sec =5.05 MHz

Similarly, the dc gain of the low pass filter is given by:

A_o ~ = ~ 20log( G_m * R_{n i} ) ~ = ~ 20log( 1*10^-3 * 33.33 * 10^3 ) ~ = ~ 30.457 dB

These values can be verified to be very close to those obtained from the simulation waveform of the output voltage (Enclose in colored rectangles in the cursor window). The slight differences are due to the fact that there are also parasitic capacitances which will decrease the bandwidth but which we have ignored in out analysis for simplicity.

- The output current waveform is expected to be a straight line of -60 dB (1mS) throughout the range of frequencies. However, due to the introduction of the resistor, the current throught the capacitor now has a high pass response since at low frequencies, the resistor impedance dominates the capacitor impedance in parallel combination and all the current flows through the resistor giving a low value for current through the capacitor. In the range of 100 Mhz to 1 Ghz, the response is exactly correct and gives a value of -60 dBm as can be observed from the cursor values.

Now that we have built the transconductor using common mode feedback, the final step is to realize the fully differential circuit by replacing the voltage controlled current sources in our earlier design with actual transistor implementations that we have used. We also note the sizes of the transistors that have been used to realize the transconductor. The NMOS input transistors have a length of 0.5 micron and a width of 1.77 micron with 8 parallel fingers. The PMOS load transistors use the same length and width but double the number of parallel fingers. This is done since the mobility of holes is approximately half the mobility of the electrons and we want to sustain the same current through both the NMOS and PMOS transistors.

4. Transistor Level Implementation:

Circuit Schematic

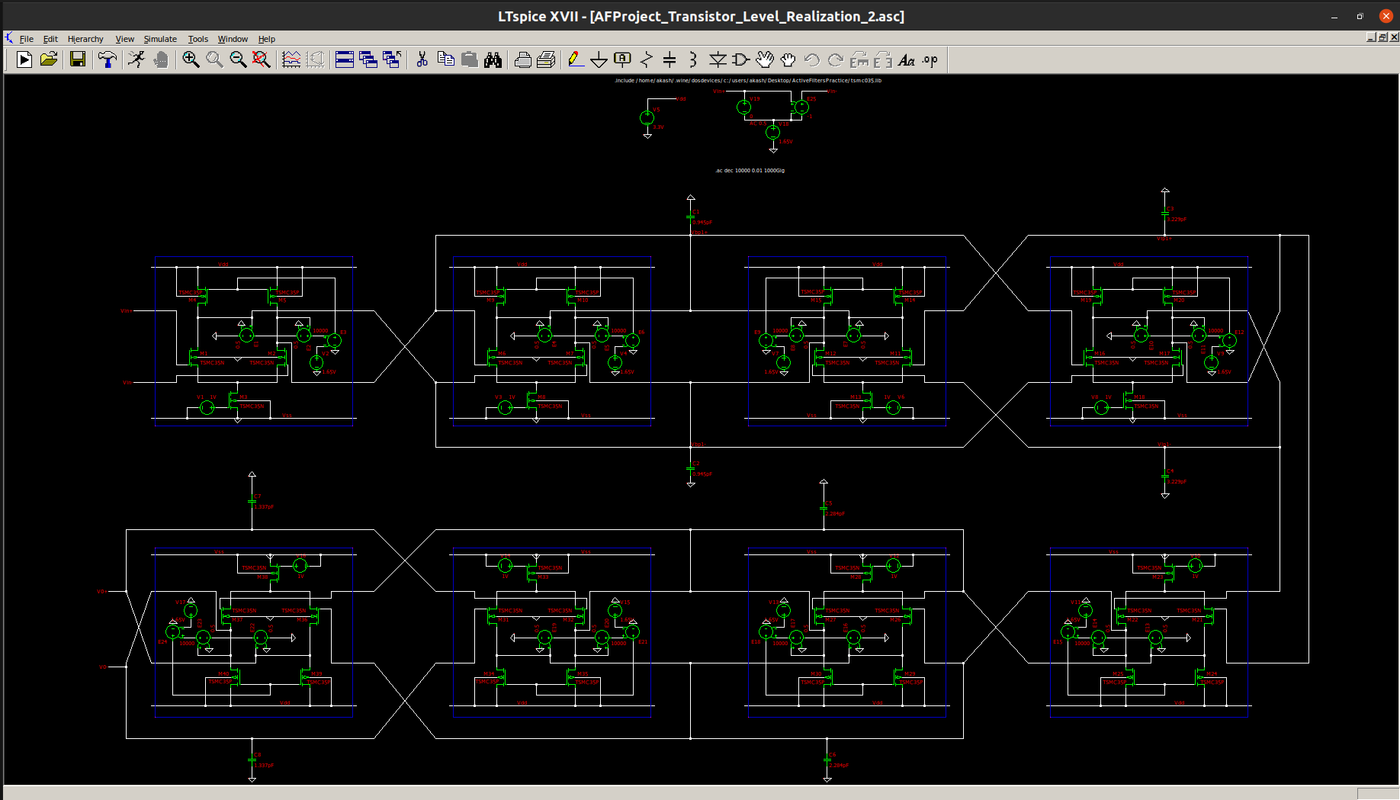
[picture p27: figure]

Output Waveform at first Band Pass Node:

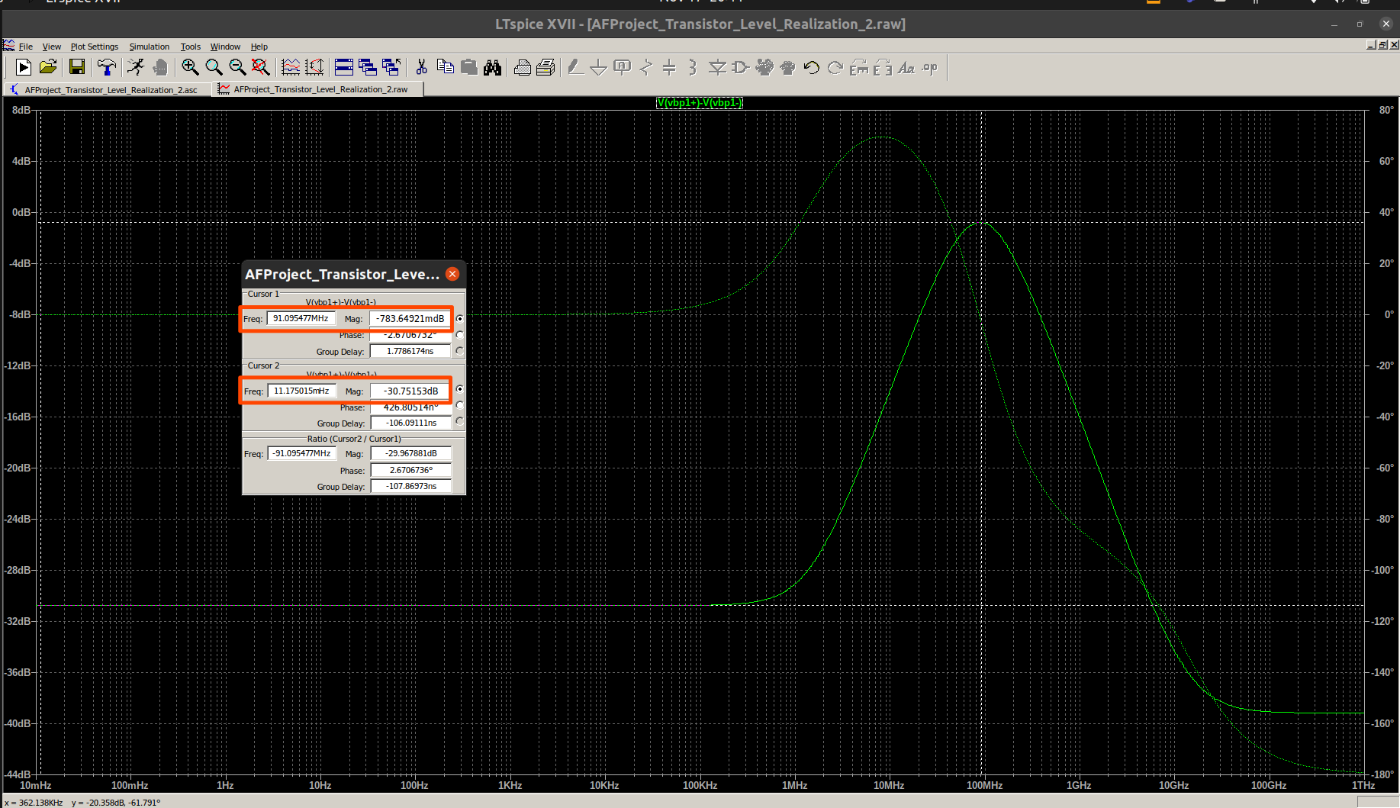
[picture p28: figure]

Rolloff at raising edge of first Band Pass Node:

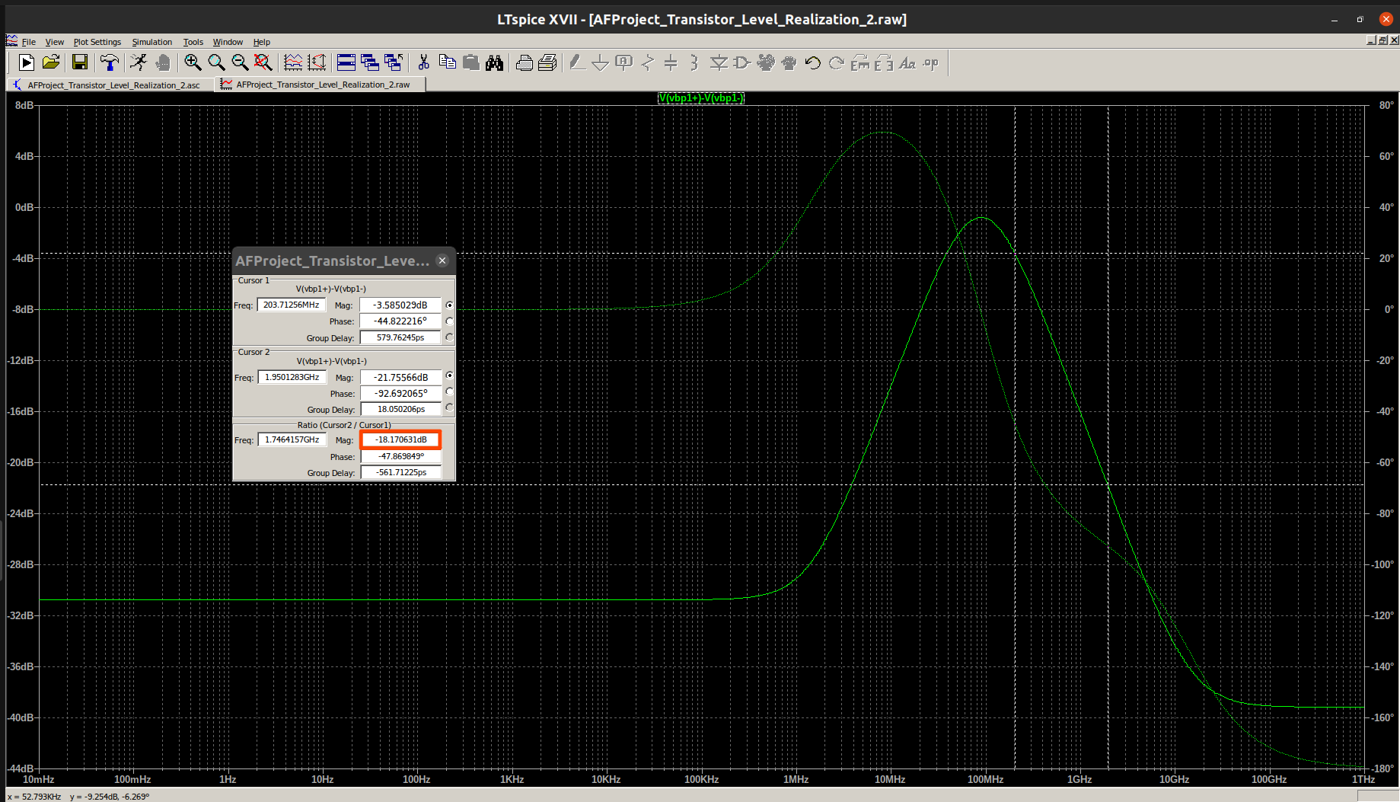
[picture p29: figure]

Rolloff at Falling Edge of first Bandpass Node:

Output Waveform at First Low Pass Node:

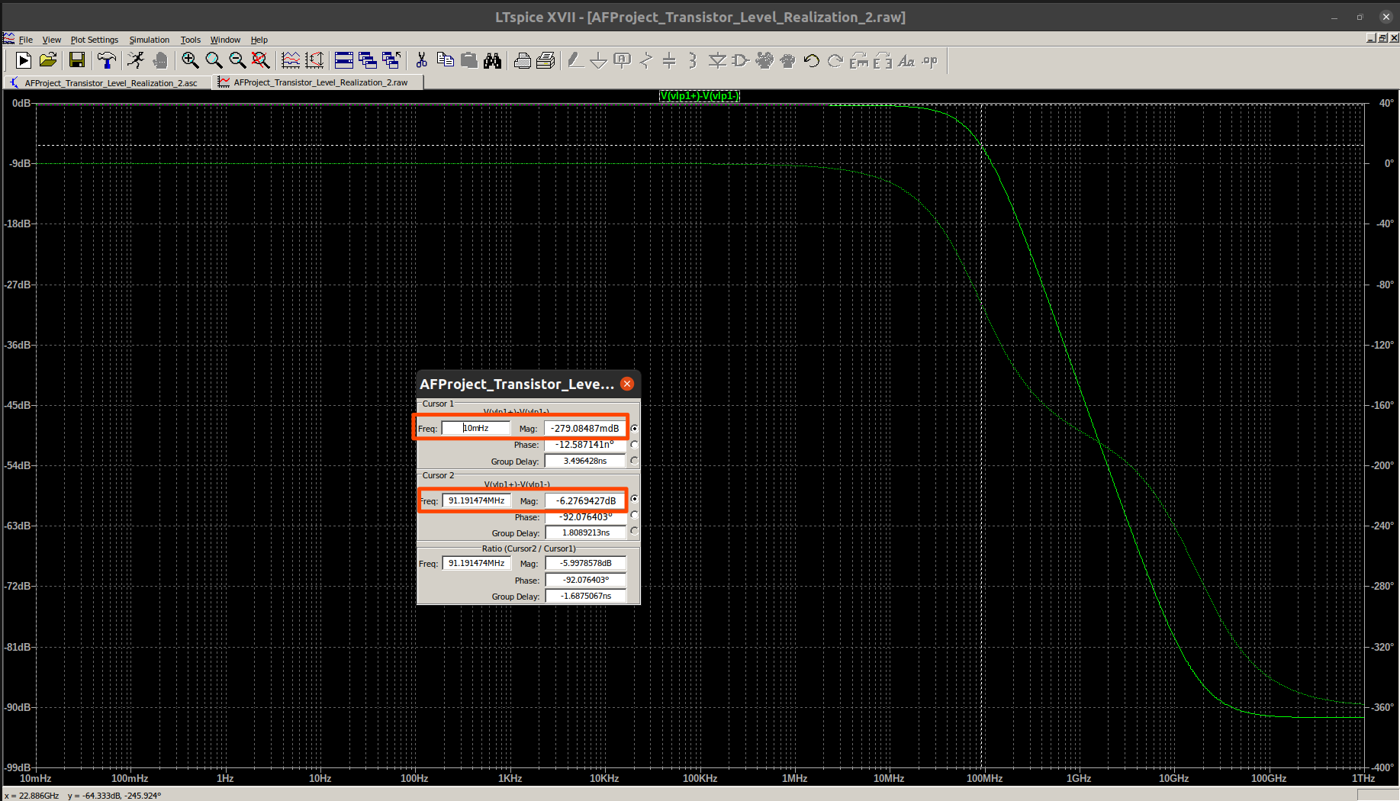
[picture p30: figure]

Rolloff at First Low Pass Node:

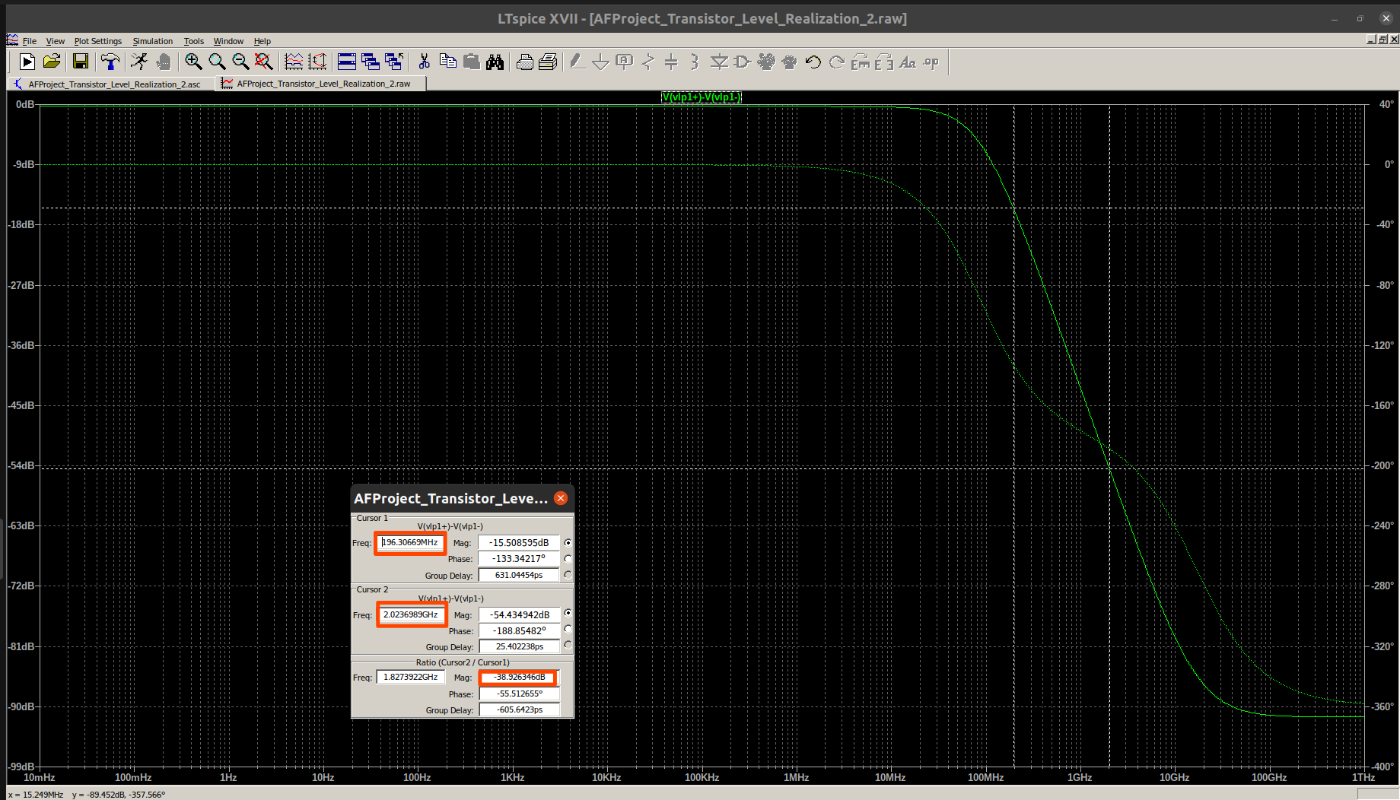
[picture p31: figure]

Waveform at Output Node:

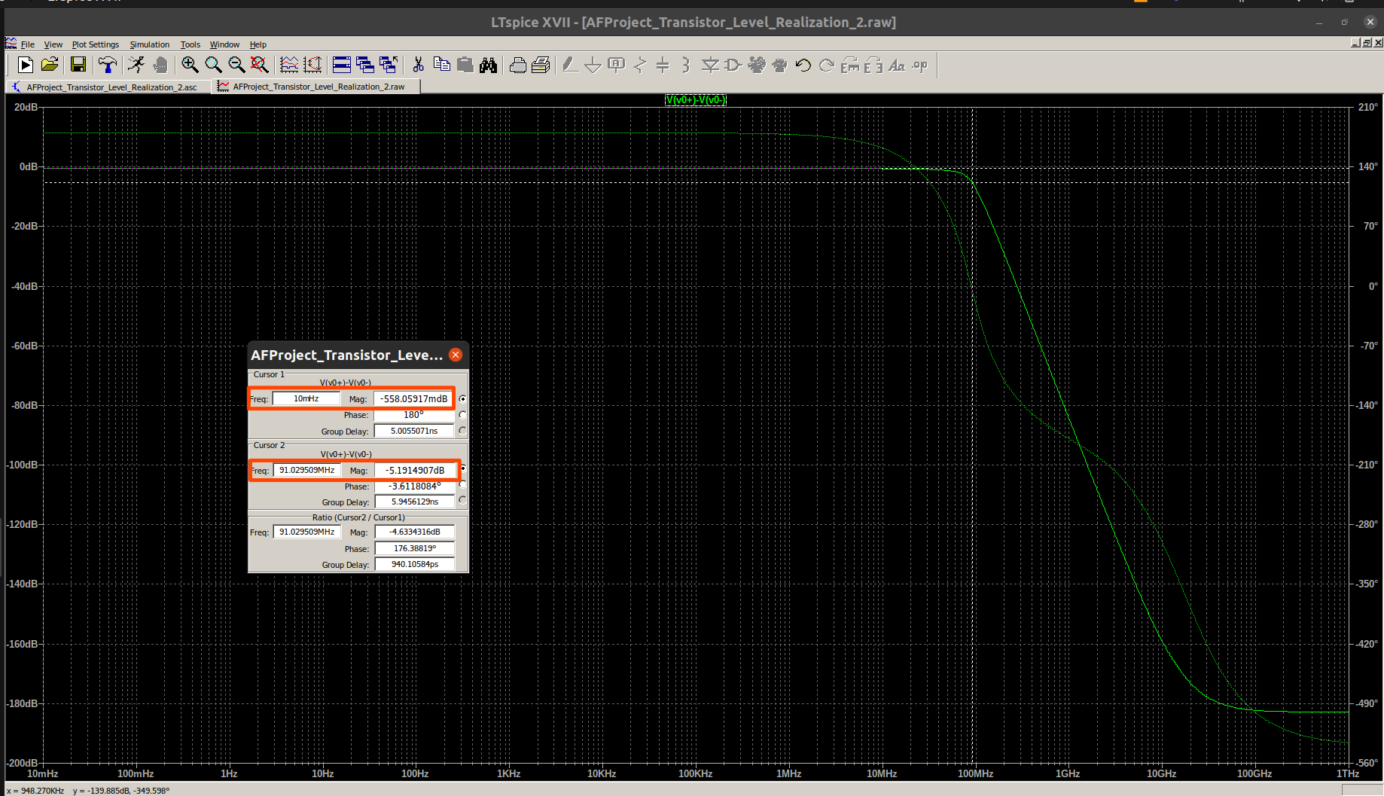
[picture p32: figure]

Rolloff at Output Node:

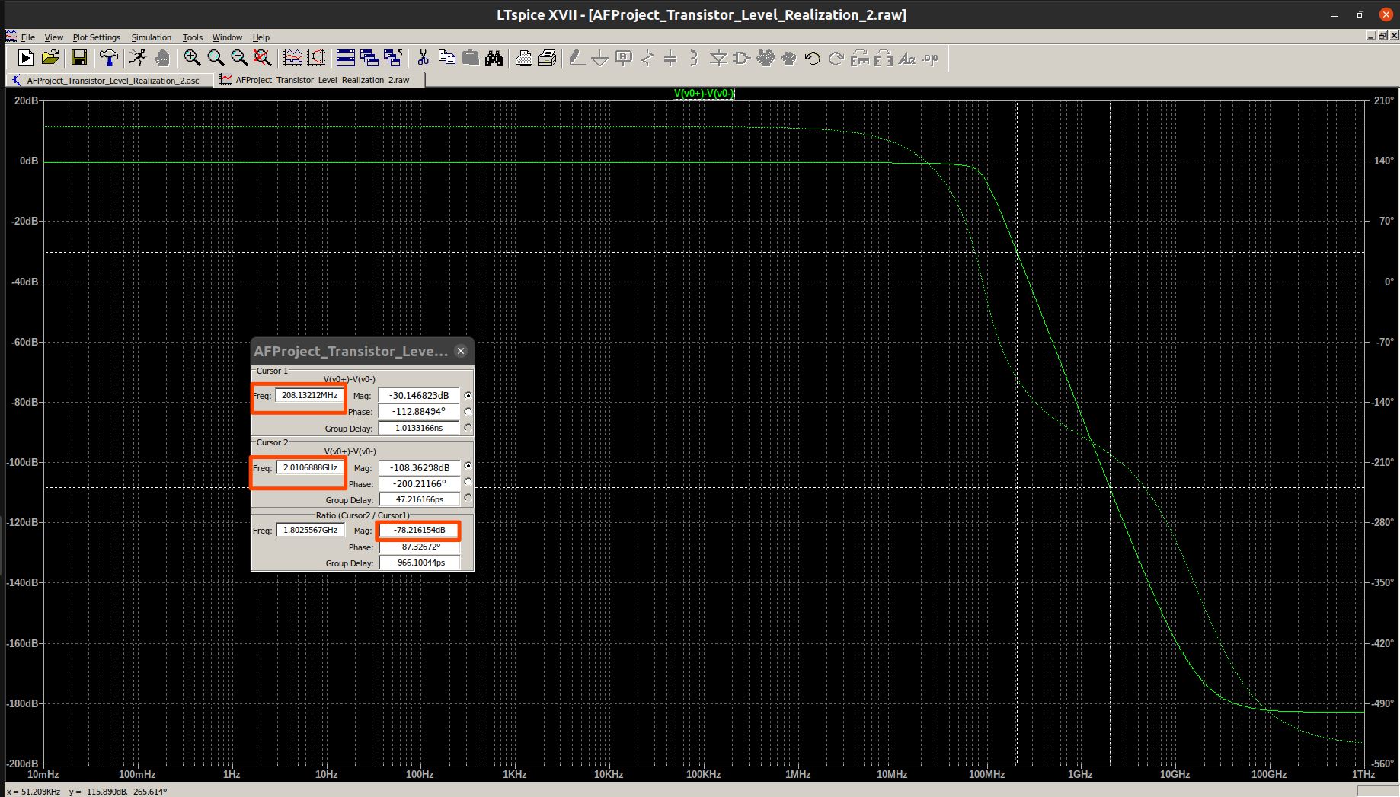
[picture p33: figure]

Observations:

- At the first band pass node, we observe that the peak in the waveform occurs at around 91 Mhz. This, if we recall is the passband edge of the Butterworth filter that we had designed which means that the passband edge has been accurately obtained. The rolloff at the raising and falling edge is also about 20 dB/decade which is also as per our expectations. However, the gain at the passband edge is not 0dB but a passband gain of around -785 millidecibels is observed. Further, at low frequencies, the gain in dB should ideally go to negative infinity but it is observed to stabilize at around -30.7 dB. We now try to see if the lossy transconductor has contributed to these changes. Shown below is the Gm – C realization of the band pass filter with lossy transconductances.

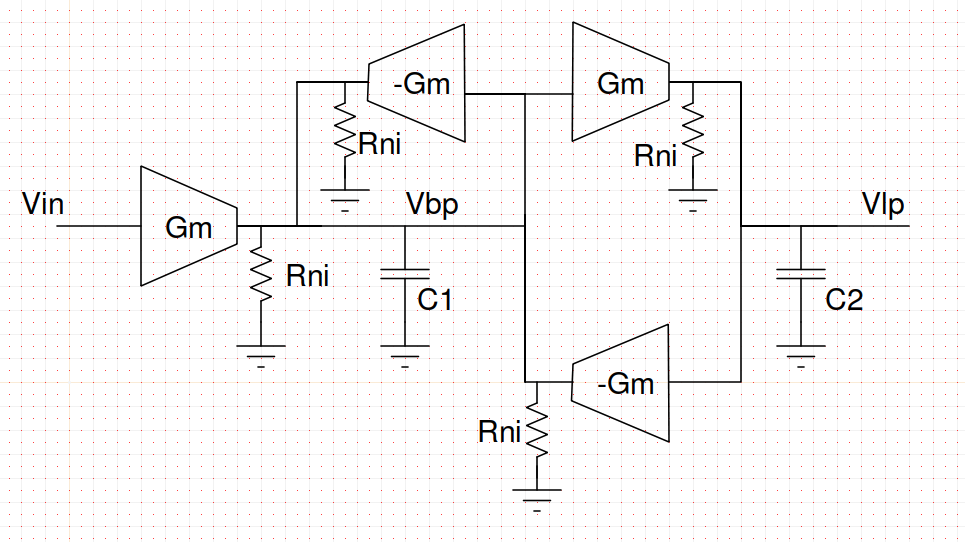
[picture p34: figure]

We are now required to analyze the above circuit for the Vbp node. At node Vbp, three resistors are in parallel which can be combined together. Similarly, the load of the gyrator is a resistor in parallel with a capacitor. This gives an effective impedance of an inductor in series with a resistor at the input of the gyrator. The values of the resistor and inductor can easily br derived from the relation for the input impedance of a gyrator:

Z_{ i n } ~ = ~ Y_L over G_m ^2

where YL is the load admittance. In our case,

Z_{ i n } ~ = ~ 1 over G_m^2 * ( 1 over R_{n i} + C_2 s) ~ = R_{ LOSSY,2 }+Ls ~ where ~ R_{ LOSSY,2 } ~ = ~ 1 over { G_m^2 R_{n i} } and L = C_2 over G_m^2

The RLC equivalent of the above circuit is as shown below. Note that we have also converted the initial voltage source along with Gm into a current source to completely eliminate transconductors from the circuit.

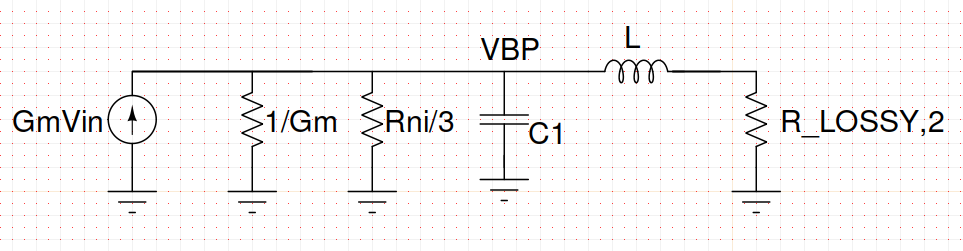
[picture p35: figure]

The above circuit is now relatively simpler to analyze. In order to further simplify our analysis, we replace the the circuit on the left hand side of node Vbp by its Thevinin’s equivalent. The resultant circuit is as shown below:

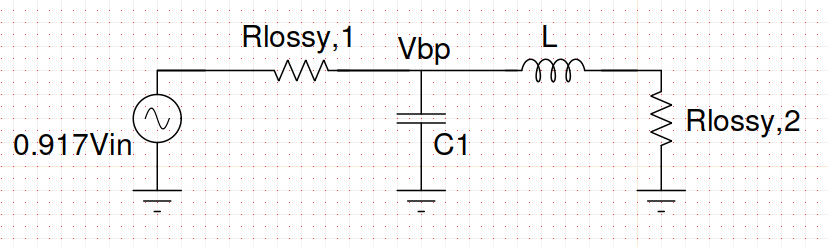
[picture p36: figure]

The values of the components are as shown below:

R_{ LOSSY,1 } ~ = ~ 0.917 k %OMEGA , ~ R_{ LOSSY, 2 } ~ = ~ 30 %OMEGA , ~ C_1 ~ = ~ 0.945 pF,~ L ~ = ~ 3.229 %mu H

The expression for the transfer function at the passband node is as shown below:

{V_{ BP }( s )} over { V_{i n}(s) } ~ = ~ { R_{LOSSY,2} over {R_{LOSSY,1} + R_{LOSSY,2}} + L over { R_{LOSSY,1} + R_{LOSSY,2} }s } over { {R_{LOSSY,1}LCs^2} over {R_{LOSSY,1}+R_{LOSSY,2}} + {(R_{LOSSY,1}R_{LOSSY,2}C+L)s} over {R_{LOSSY,1}+R_{LOSSY,2}} + 1 }

The above expression is approximately of the form:

{V_{ BP }( s )} over { V_{i n}(s) } ~ = ~ { A_0 + 1 over Q (s over %omega _0) } over { (s over %omega _0)^2 + 1 over Q (s over %omega _0) + 1 }

This is similar to the standard bandpass transfer function except for the A0 term. The A0 term contributes to the constant gain at very low frequencies that we observed in the waveform. Thus, the dc gain of the circuit can be expressed as:

DC ~gain ~ = ~ 20log( A_0 ) ~ = ~ 20log( R_{LOSSY,2} over {R_{LOSSY,1} + R_{LOSSY,2}} ) ~ = ~ -30dB

For passband gain, we can ignore the A0 term. Hence the passband gain only comes from the fact that we are applying not the entire input but 0.917 times the input due to the Thevinin’s equivalent. The passband gain is thus given by the relation:

Passband Gain ~ = ~ 20log( 0.917 ) ~ = ~ -752millidecibels

This is consistent with the output that we had observed at the bandpass node.

- At the first low pass node, we observe that there is a gain of about -279 millidecibels. Further, at the Butterworth passband edge, the gain is about -6.296dB. Similar to the badpass node, we try to prove by mathematical analysis that the above results have occured due to the lossy transconductor. The effective circuit for the low pass node from the bandpass node output can be shown to be as below:

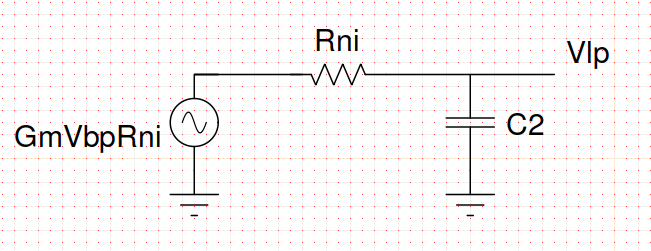
[picture p37: figure]

The transfer function for the low pass node can then be written to be of the form:

{V_{ LP }( s )} over { V_{i n}(s) } ~ = ~ { R_{LOSSY,2} over {R_{LOSSY,1} + R_{LOSSY,2}} + L over { R_{LOSSY,1} + R_{LOSSY,2} }s } over { {R_{LOSSY,1}LCs^2} over {R_{LOSSY,1}+R_{LOSSY,2}} + {(R_{LOSSY,1}R_{LOSSY,2}C+L)s} over {R_{LOSSY,1}+R_{LOSSY,2}} + 1 } ~ * ~ ( {G_m R_{n i}} over {1 + R_{n i}C_2 s})

In order to find the dc gain, we set s = 0. This gives us:

DC Gain ~ = ~ G_m R_{ n i } * {R_{ LOSSY,2 }} over { R_{LOSSY,1} + R_{LOSSY,2} } ~ = ~ -282 millidecibels

At the passband edge, we can make the approximation:

1+R_{ n i }C_2 s approx R_{ n i }C_2 s

This in turn gives us the simpler transfer function:

{V_{ LP } ( s )} over { V_{i n}(s) } ~ = ~ { {G_m L} over {C_2 R_{LOSSY,1}} } over { LC_1 s^2 + L over R_{LOSSY,1} s + 1 }

From the above result, we observe that the passband edge is almost the same but there is a change in the quality factor since we now have a resistor of 917 ohm instead of a 1k resistor that was ideally needed. The new quality factor which is also the gain at the Butterworth passband edge is given by:

Q_1 ~ = ~ R_{ LOSSY,1 } over sqrt( L over C_1 ) ~ = ~ 0.496

The theoretical value of the quality factor that we had to realize was 0.541. Thus the gain at the passband edge now works out to be anout -6.09 dB while the theoretical value is -5.336 dB. To this, we also need to add the dc gain of -0.28 dB which -6.37 dB which is quite close to the experimental value.

- Finally for the observations at the output node, we obtain that it is almost close to a low pass response but the gain at the Butterworth passband edge is about -5.19 dB (expected -3 dB) and there is also a dc gain of -558 millidecibels. The reason for this can be attributed to the fact that each of the Gm – C biquads offers a dc gain of approximately -280 millidecibels (since the dc gain expression for low pass node derived earlier is independent of the L and C values, it will be same for both the biquads). Further, we can prove using similar analysis as above that the quality factor of the second biquad will also change since we are having a resistance of 917 ohm instead of ideal 1k resistor that we needed in the RLC realization. The new quality factor for the second biquad works out to be 1.1985 instead of 1.307 that is theoretically needed. The gain at the Butterworth passband edge is then given to be:

Passband Gain ~ = ~ 20log( Q_1 * Q_2 ) + DC Gain ~ = ~ -5.081 dB

This is almost in line with the simulation value. Thus, we can say that the circuit that we have designed is correct.

Conclusion:

A fourth order maximally flat low pass filter has been successfully designed and tested for the given specifications. The final results are in close proximity to the ideal values and the reasons for the minor deviations have been explained.
