akashskyash007/Fourth-Order-Gm-C-Chebyshev-Filter/Gm-C Biquad before Frequency Scaling.png

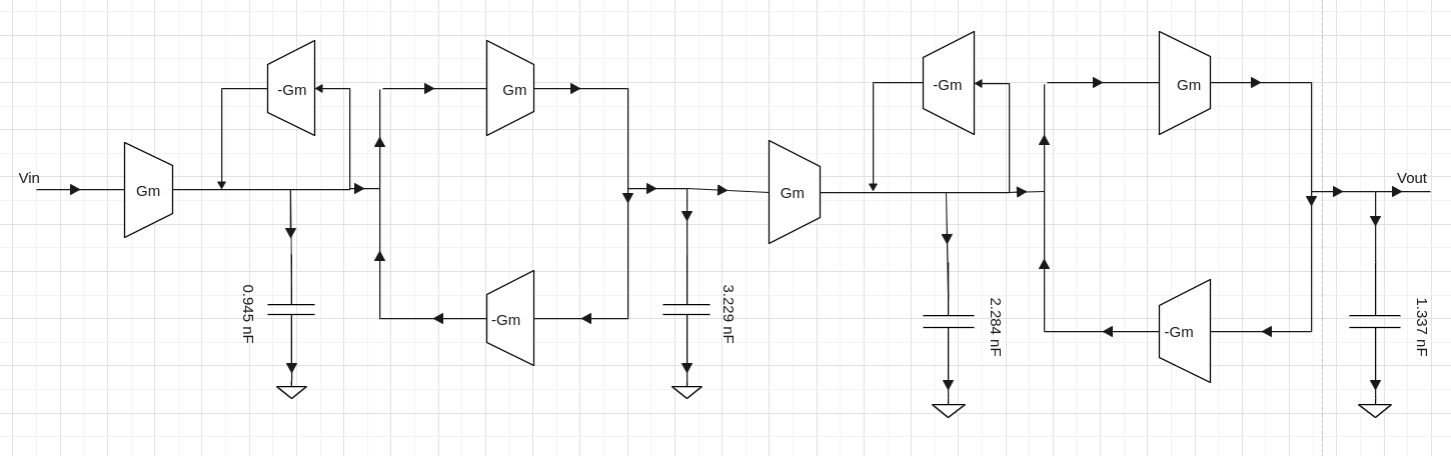
Gm-C Biquad before Frequency Scaling.png
