akashskyash007/Fourth-Order-Gm-C-Chebyshev-Filter/Waveforms/Final_Circuit_First_BP_Node_Rolloff1.png

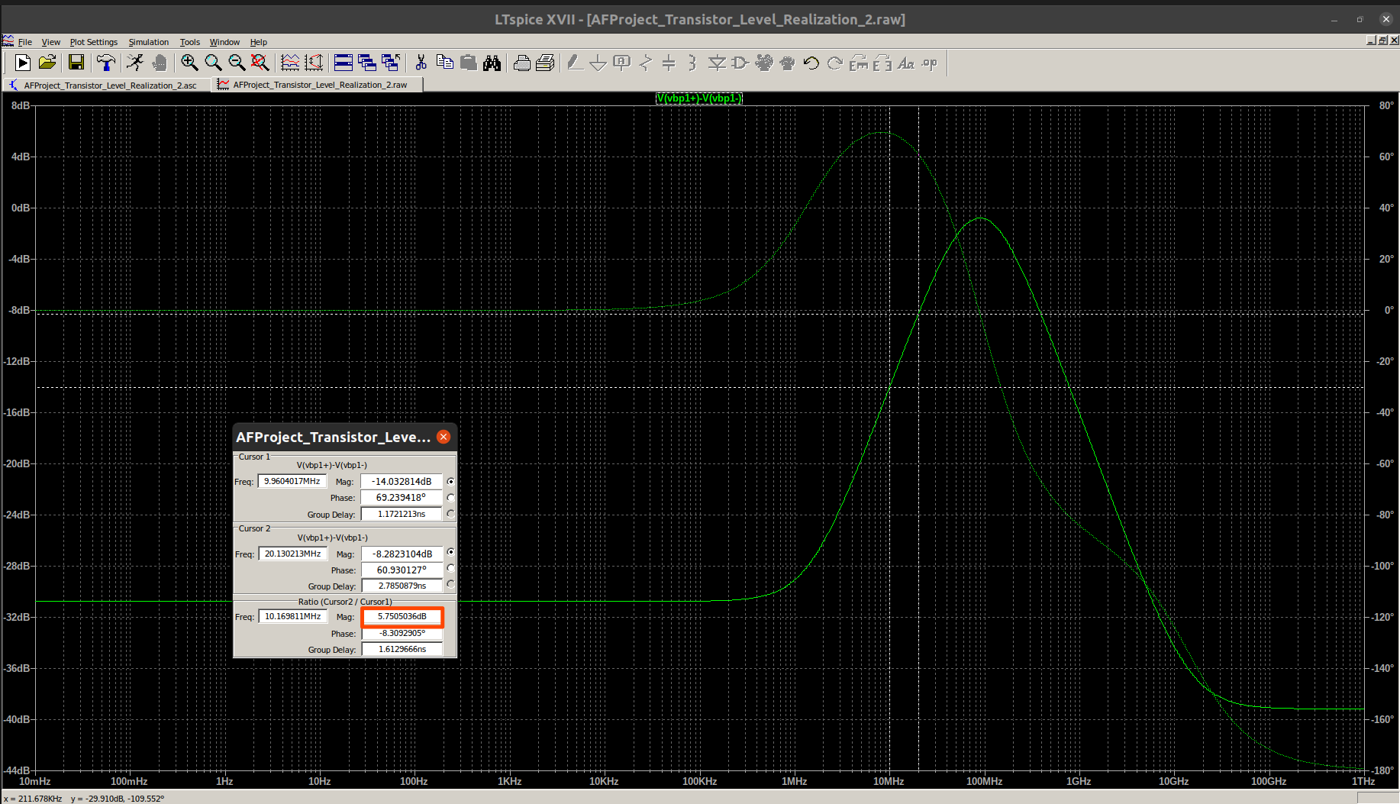
Waveforms/Final_Circuit_First_BP_Node_Rolloff1.png
