akashskyash007/Fourth-Order-Gm-C-Chebyshev-Filter/Waveforms/Final_Circuit_Output_Waveform_Without_Measurements.png

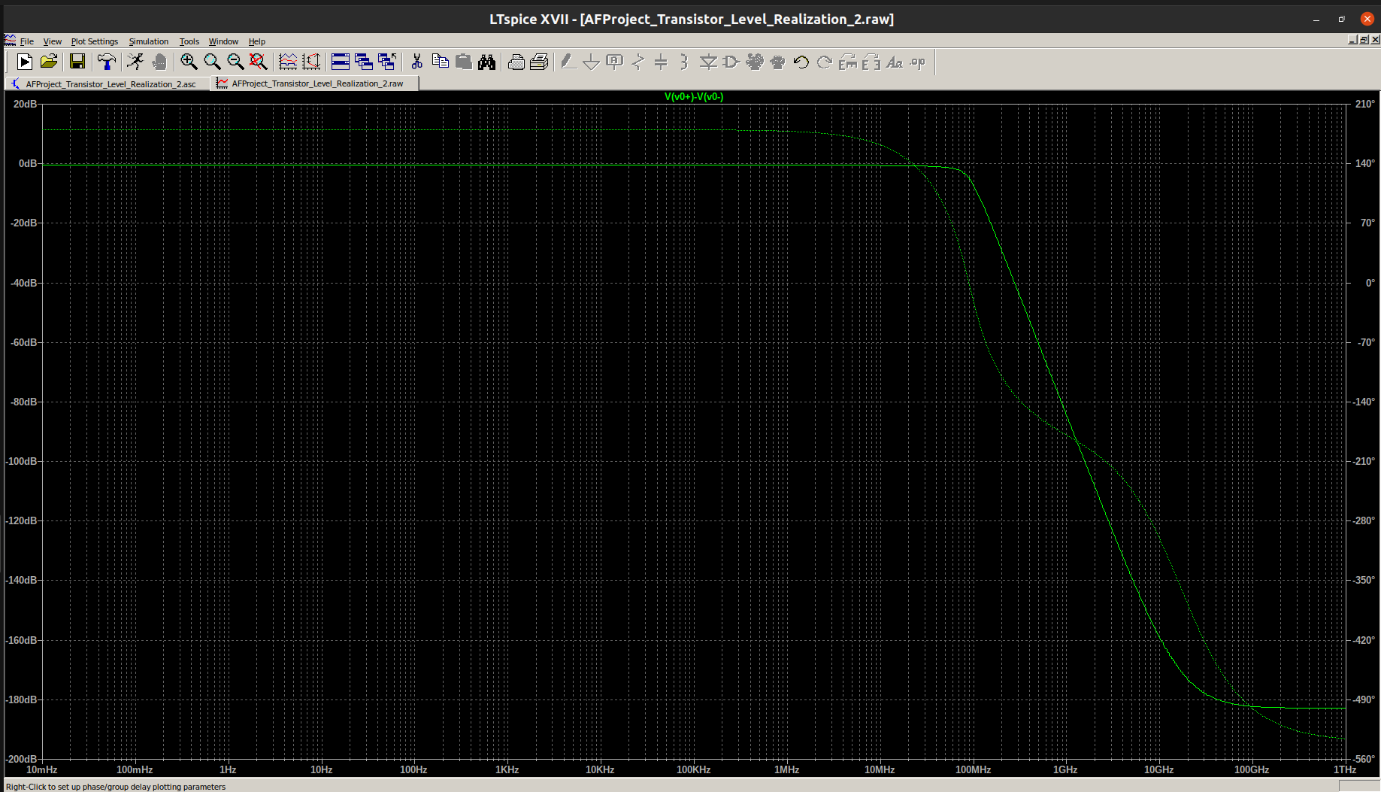
Waveforms/Final_Circuit_Output_Waveform_Without_Measurements.png
