akashskyash007/Fourth-Order-Gm-C-Chebyshev-Filter/NMOS_Input_Characteristics.asc

M1: nmos4; TSMC35N; l=0.5u w=5u
V1: voltage; 1.65V
V2: voltage; 3.3V
Named nets: 0
.include /home/akash/.wine/dosdevices/c:/users/akash/Desktop/ActiveFiltersPractice/tsmc035.lib
.dc V1 0 3.3 0.001
NMOS Input Characteristics
