akashskyash007/Fourth-Order-Gm-C-Chebyshev-Filter/PMOS_Output_Characteristics.asc

M1: pmos4; TSMC35P; l=0.5u w=5u
V1: voltage; 1.65V
V2: voltage; 1.65V
V3: voltage; 3.3
Named nets: 0
.dc V1 0 3.3 0.0001
.include /home/akash/.wine/dosdevices/c:/users/akash/Desktop/ActiveFiltersPractice/tsmc035.lib
PMOS Output Characteristics
