akashskyash007/Fourth-Order-Gm-C-Chebyshev-Filter/AF_Project_Transistor_Level_Realization.asc

C1: cap; 0.945pF
C2: cap; 0.945pF
C3: cap; 3.229pF
C4: cap; 3.229pF
C5: cap; 2.284pF
C6: cap; 2.284pF
C7: cap; 1.337pF
C8: cap; 1.337pF
M1: nmos4; TSMC35N; l=0.5u w=55u m=2
M2: nmos4; TSMC35N; l=0.5u w=55u m=2
M3: nmos4; TSMC35N; l=0.5u w=12.2093u m=2
M4: pmos4; TSMC35P; l=0.5u w=2u m=2
M5: pmos4; TSMC35P; l=0.5u w=2u m=2
M6: nmos4; TSMC35N; l=0.5u w=55u m=2
M7: nmos4; TSMC35N; l=0.5u w=55u m=2
M8: nmos4; TSMC35N; l=0.5u w=12.2093u m=2
M9: pmos4; TSMC35P; l=0.5u w=2u m=2
M10: pmos4; TSMC35P; l=0.5u w=2u m=2
M11: nmos4; TSMC35N; l=0.5u w=55u m=2
M12: nmos4; TSMC35N; l=0.5u w=55u m=2
M13: nmos4; TSMC35N; l=0.5u w=12.2093u m=2
M14: pmos4; TSMC35P; l=0.5u w=2u m=2
M15: pmos4; TSMC35P; l=0.5u w=2u m=2
M16: nmos4; TSMC35N; l=0.5u w=55u m=2
M17: nmos4; TSMC35N; l=0.5u w=55u m=2
M18: nmos4; TSMC35N; l=0.5u w=12.2093u m=2
M19: pmos4; TSMC35P; l=0.5u w=2u m=2
M20: pmos4; TSMC35P; l=0.5u w=2u m=2
M21: nmos4; TSMC35N; l=0.5u w=55u m=2
M22: nmos4; TSMC35N; l=0.5u w=55u m=2
M23: nmos4; TSMC35N; l=0.5u w=12.2093u m=2
M24: pmos4; TSMC35P; l=0.5u w=2u m=2
M25: pmos4; TSMC35P; l=0.5u w=2u m=2
M26: nmos4; TSMC35N; l=0.5u w=55u m=2
M27: nmos4; TSMC35N; l=0.5u w=55u m=2
M28: nmos4; TSMC35N; l=0.5u w=12.2093u m=2
M29: pmos4; TSMC35P; l=0.5u w=2u m=2
M30: pmos4; TSMC35P; l=0.5u w=2u m=2
M31: nmos4; TSMC35N; l=0.5u w=55u m=2
M32: nmos4; TSMC35N; l=0.5u w=55u m=2
M33: nmos4; TSMC35N; l=0.5u w=12.2093u m=2
M34: pmos4; TSMC35P; l=0.5u w=2u m=2
M35: pmos4; TSMC35P; l=0.5u w=2u m=2
M36: nmos4; TSMC35N; l=0.5u w=55u m=2
M37: nmos4; TSMC35N; l=0.5u w=55u m=2
M38: nmos4; TSMC35N; l=0.5u w=12.2093u m=2
M39: pmos4; TSMC35P; l=0.5u w=2u m=2
M40: pmos4; TSMC35P; l=0.5u w=2u m=2
R1: res; 1k
R2: res; 1k
R3: res; 2.3k
R4: res; 1k
R5: res; 1k
R6: res; 1k
R7: res; 2.3k
R8: res; 1k
R9: res; 1k
R10: res; 1k
R11: res; 2.3k
R12: res; 1k
R13: res; 1k
R14: res; 1k
R15: res; 2.3k
R16: res; 1k
R17: res; 1k
R18: res; 1k
R19: res; 2.3k
R20: res; 1k
R21: res; 1k
R22: res; 1k
R23: res; 2.3k
R24: res; 1k
R25: res; 1k
R26: res; 1k
R27: res; 2.3k
R28: res; 1k
R29: res; 1k
R30: res; 1k
R31: res; 2.3k
R32: res; 1k
V1: voltage; 3.3
V2: voltage; 1.65; AC 1
V3: voltage; -1.65V; AC 1
Named nets: 0, Vss, Vdd, Vin+, Vin-, Vout+, Vout-
.include /home/akash/.wine/dosdevices/c:/users/akash/Desktop/ActiveFiltersPractice/tsmc035.lib
.ac dec 1000 0.01 1000Gig
