akashskyash007/Fourth-Order-Gm-C-Chebyshev-Filter/AFProject_Macromodel_Fully_Differential.asc

C1: cap; 0.945pF
C2: cap; 0.945pF
C3: cap; 3.229pF
C4: cap; 3.229pF
C5: cap; 2.284pF
C6: cap; 2.284pF
C7: cap; 1.337pF
C8: cap; 1.337pF
E1: e; -1
G1: g; -1m
G2: g; -1m
G3: g; -1m
G4: g; -1m
G5: g; -1m
G6: g; -1m
G7: g; -1m
G8: g; -1m
G9: g; -1m
G10: g; -1m
G11: g; -1m
G12: g; -1m
G13: g; -1m
G14: g; -1m
G15: g; -1m
G16: g; -1m
V1: voltage; 1.65V
V2: voltage; 0; AC 0.5
Named nets: 0, Vo+, Vo-, Vin+, Vin-
.ac dec 1000 0.1 100Gig
