akashskyash007/Fourth-Order-Gm-C-Chebyshev-Filter/AFProject_Macromodel_Realization.asc

C1: cap; 3.229pF
C2: cap; 1.337pF
C3: cap; 3.229pF
C4: cap; 1.337pF
C5: cap; 0.945pF
C6: cap; 3.229pF
C7: cap; 2.284pF
C8: cap; 1.337pF
G1: g; 1m
G2: g; -1m
G3: g; 1m
G4: g; -1m
G5: g; 1m
G6: g; -1m
G7: g; 1m
G8: g; -1m
L1: ind; 0.945µH; Rser=0
L2: ind; 2.284µH; Rser=0
L3: ind; 0.945µH; Rser=0
L4: ind; 2.284µH; Rser=0
R1: res; 1k
R2: res; 1k
R3: res; 1k
R4: res; 1k
U1: UniversalOpamp2; Avol=1Meg GBW=10000Gig Slew=10000Gig
V1: voltage; SINE(0 10); AC 1
V2: voltage; 12V
V3: voltage; 12V
Named nets: 0, Vin, Vlp1, Vlp2, Vx, Vout, Vomac
First Stage RLC
Second Stage RLC
.ac dec 1000 0.1 110Gig
Fourth Order Maximally Flat Response
Filter Realization using Macromodel of Gm
