akashskyash007/Fourth-Order-Gm-C-Chebyshev-Filter/AFProject_Transistor_Level_Realization_2.asc

C1: cap; 0.945pF
C2: cap; 0.945pF
C3: cap; 3.229pF
C4: cap; 3.229pF
C5: cap; 2.284pF
C6: cap; 2.284pF
C7: cap; 1.337pF
C8: cap; 1.337pF
E1: e; 0.5
E2: e; 0.5
E3: e; 10000
E4: e; 0.5
E5: e; 0.5
E6: e; 10000
E7: e; 0.5
E8: e; 0.5
E9: e; 10000
E10: e; 0.5
E11: e; 0.5
E12: e; 10000
E13: e; 0.5
E14: e; 0.5
E15: e; 10000
E16: e; 0.5
E17: e; 0.5
E18: e; 10000
E19: e; 0.5
E20: e; 0.5
E21: e; 10000
E22: e; 0.5
E23: e; 0.5
E24: e; 10000
E25: e; -1
M1: nmos4; TSMC35N; l=0.5u w=1.77u m=8
M2: nmos4; TSMC35N; l=0.5u w=1.77u m=8
M3: nmos4; TSMC35N; l=0.5u w=1.33u m=16
M4: pmos4; TSMC35P; l=0.5u w=1.77u m=18
M5: pmos4; TSMC35P; l=0.5u w=1.77u m=18
M6: nmos4; TSMC35N; l=0.5u w=1.77u m=8
M7: nmos4; TSMC35N; l=0.5u w=1.77u m=8
M8: nmos4; TSMC35N; l=0.5u w=1.33u m=16
M9: pmos4; TSMC35P; l=0.5u w=1.77u m=18
M10: pmos4; TSMC35P; l=0.5u w=1.77u m=18
M11: nmos4; TSMC35N; l=0.5u w=1.77u m=8
M12: nmos4; TSMC35N; l=0.5u w=1.77u m=8
M13: nmos4; TSMC35N; l=0.5u w=1.33u m=16
M14: pmos4; TSMC35P; l=0.5u w=1.77u m=18
M15: pmos4; TSMC35P; l=0.5u w=1.77u m=18
M16: nmos4; TSMC35N; l=0.5u w=1.77u m=8
M17: nmos4; TSMC35N; l=0.5u w=1.77u m=8
M18: nmos4; TSMC35N; l=0.5u w=1.33u m=16
M19: pmos4; TSMC35P; l=0.5u w=1.77u m=18
M20: pmos4; TSMC35P; l=0.5u w=1.77u m=18
M21: nmos4; TSMC35N; l=0.5u w=1.77u m=8
M22: nmos4; TSMC35N; l=0.5u w=1.77u m=8
M23: nmos4; TSMC35N; l=0.5u w=1.33u m=16
M24: pmos4; TSMC35P; l=0.5u w=1.77u m=18
M25: pmos4; TSMC35P; l=0.5u w=1.77u m=18
M26: nmos4; TSMC35N; l=0.5u w=1.77u m=8
M27: nmos4; TSMC35N; l=0.5u w=1.77u m=8
M28: nmos4; TSMC35N; l=0.5u w=1.33u m=16
M29: pmos4; TSMC35P; l=0.5u w=1.77u m=18
M30: pmos4; TSMC35P; l=0.5u w=1.77u m=18
M31: nmos4; TSMC35N; l=0.5u w=1.77u m=8
M32: nmos4; TSMC35N; l=0.5u w=1.77u m=8
M33: nmos4; TSMC35N; l=0.5u w=1.33u m=16
M34: pmos4; TSMC35P; l=0.5u w=1.77u m=18
M35: pmos4; TSMC35P; l=0.5u w=1.77u m=18
M36: nmos4; TSMC35N; l=0.5u w=1.77u m=8
M37: nmos4; TSMC35N; l=0.5u w=1.77u m=8
M38: nmos4; TSMC35N; l=0.5u w=1.33u m=16
M39: pmos4; TSMC35P; l=0.5u w=1.77u m=18
M40: pmos4; TSMC35P; l=0.5u w=1.77u m=18
V1: voltage; 1V
V2: voltage; 1.65V
V3: voltage; 1V
V4: voltage; 1.65V
V5: voltage; 3.3V
V6: voltage; 1V
V7: voltage; 1.65V
V8: voltage; 1V
V9: voltage; 1.65V
V10: voltage; 1V
V11: voltage; 1.65V
V12: voltage; 1V
V13: voltage; 1.65V
V14: voltage; 1V
V15: voltage; 1.65V
V16: voltage; 1V
V17: voltage; 1.65V
V18: voltage; 1.65V
V19: voltage; 0; AC 0.5
Named nets: 0, Vdd, Vss, Vin+, Vin-, V0+, V0-, Vbp1+, Vbp1-, Vlp1+, Vlp1-
.include /home/akash/.wine/dosdevices/c:/users/akash/Desktop/ActiveFiltersPractice/tsmc035.lib
.ac dec 10000 0.01 1000Gig
