akashskyash007/Fourth-Order-Gm-C-Chebyshev-Filter/Draft1.asc

C1: cap; 0.945pF
C2: cap; 0.945pF
I1: current; 0.2mA
M1: nmos4; CMOSN; l=0.5u w=80u
M2: pmos4; CMOSP; l=0.5u w=8.3u
M3: nmos4; CMOSN; l=0.5u w=80u
M4: pmos4; CMOSP; l=0.5u w=8.3u
V1: voltage; 3.3V
V2: voltage; 1.65V
V3: voltage; SINE(1.65 0.165 100Meg)
V4: voltage; 1.65V
V5: voltage; 1.65V
Named nets: 0, Vy, Vx, Vz
.include /home/akash/.wine/dosdevices/c:/users/akash/Desktop/ActiveFiltersPractice/tsmc035.lib
.tran 0 100ns 0 0.01ns
