akashskyash007/Fourth-Order-Gm-C-Chebyshev-Filter/Draft5.asc

M1: nmos4; TSMC35N; l=0.5u w=26.5u
V1: voltage; 1.65V
V2: voltage; 0.83V
V3: voltage; 1.65V
Named nets: 0
.include /home/akash/.wine/dosdevices/c:/users/akash/Desktop/ActiveFiltersPractice/tsmc035.lib
.op
