akashskyash007/Fourth-Order-Gm-C-Chebyshev-Filter/Final_Transconductor.asc

C1: cap; 0.945pF
C2: cap; 0.945pF
M1: nmos4; TSMC35N; l=0.5u w=55u m=2
M2: nmos4; TSMC35N; l=0.5u w=55u m=2
M3: nmos4; TSMC35N; l=0.5u w=12.2093u m=2
M4: pmos4; TSMC35P; l=0.5u w=2u m=2
M5: pmos4; TSMC35P; l=0.5u w=2u m=2
R1: res; 2.3k
R2: res; 1k
R3: res; 1k
R4: res; 1k
V1: voltage; 3.3V
V2: voltage; 1.65; AC 1
V3: voltage; -1.65V; AC 1
Named nets: 0, Vx, Io+, Io-, Vdd, Vss
.include /home/akash/.wine/dosdevices/c:/users/akash/Desktop/ActiveFiltersPractice/tsmc035.lib
.ac dec 1000 0.1 1000Gig
