akashskyash007/Fourth-Order-Gm-C-Chebyshev-Filter/New_Transconductor_NMOS_Biasing.asc

I1: current; 0.13mA
M1: nmos4; TSMC35N; l=0.5u w=1.77u m=8
M2: nmos4; TSMC35N; l=0.5u w=1.33u m=16
V1: voltage; 1.65V
V2: voltage; 1.65V
V3: voltage; 0.555601V
V4: voltage; 1V
Named nets: 0, Vx
.include /home/akash/.wine/dosdevices/c:/users/akash/Desktop/ActiveFiltersPractice/tsmc035.lib
.op
