akashskyash007/Fourth-Order-Gm-C-Chebyshev-Filter/Transcondoctur.asc

C1: cap; 0.945pF
C2: cap; 0.945pF
I1: current; 0.2m
I2: current; 0.1m; load
I3: current; 0.1m; load
M1: nmos4; l=1u w=100u
M2: nmos4; l=1u w=100u
V1: voltage; 1.65
V2: voltage; 1.65
V3: voltage; 3.3
Named nets: 0, Vx, Vy
.op
.model nmos nmos(kp=50u vt0=0.5)
