akashskyash007/Fourth-Order-Gm-C-Chebyshev-Filter/Transconductor.asc

C1: cap; 0.945pF
C2: cap; 0.945pF
M1: nmos4; CMOSN; l=0.5u w=21u
M2: nmos4; CMOSN; l=0.5u w=21u
M3: nmos4; CMOSN; l=0.5u w=100u
M5: pmos4; CMOSP; l=0.5u w=50u
M6: pmos4; CMOSP; l=0.5u w=50u
V1: voltage; 2.01V
V2: voltage; SINE(1.65 0.165 1Gig)
V3: voltage; 1.2V
V5: voltage; 1.65V
V6: voltage; 2.01V
V7: voltage; 3.3V
Named nets: 0, Vdd, Vss
.include /home/akash/.wine/dosdevices/c:/users/akash/Desktop/ActiveFiltersPractice/tsmc035.lib
Designing the Transconductor
.tran 0 10ns 0
