akashskyash007/Fourth-Order-Gm-C-Chebyshev-Filter/Transconductor_Bias_Width_Calculation.asc

M1: nmos4; TSMC35N; l=0.5u w=55u m=2
M2: nmos4; TSMC35N; l=0.5u w=12u m=2
M3: pmos4; TSMC35P; l=0.5u w=2u m=2
V1: voltage; 1.65V
V2: voltage; 0.83V
V3: voltage; 1.65V
V4: voltage; 1V
V5: voltage; 1.65V
V6: voltage; 0.83V
V7: voltage; 3.3V
V8: voltage; 1.65V
Named nets: 0
.include /home/akash/.wine/dosdevices/c:/users/akash/Desktop/ActiveFiltersPractice/tsmc035.lib
.op
