akashskyash007/Fourth-Order-Gm-C-Chebyshev-Filter/Transconductor_with_CMFB.asc

C1: cap; 0.945pF
C2: cap; 0.945pF
E1: e; 0.5
E2: e; 0.5
E3: e; 10000
E4: e; -1
M1: nmos4; TSMC35N; l=0.5u w=1.77u m=8
M2: nmos4; TSMC35N; l=0.5u w=1.77u m=8
M3: nmos4; TSMC35N; l=0.5u w=1.33u m=16
M4: pmos4; TSMC35P; l=0.5u w=1.77u m=18
M5: pmos4; TSMC35P; l=0.5u w=1.77u m=18
V1: voltage; 1.65V
V2: voltage; 0; AC 0.5
V3: voltage; 1.65V
V4: voltage; 1V
V5: voltage; 3.3V
Named nets: 0, Vx, Vy, Vz, Vdd, Vss, V0+, V0-, Vin+, Vin-
.include /home/akash/.wine/dosdevices/c:/users/akash/Desktop/ActiveFiltersPractice/tsmc035.lib
.ac dec 10000 0.01 1000Gig
